SparrowTheNerd/WINTER-KiCAD/production/JLC3313-Stackup.png

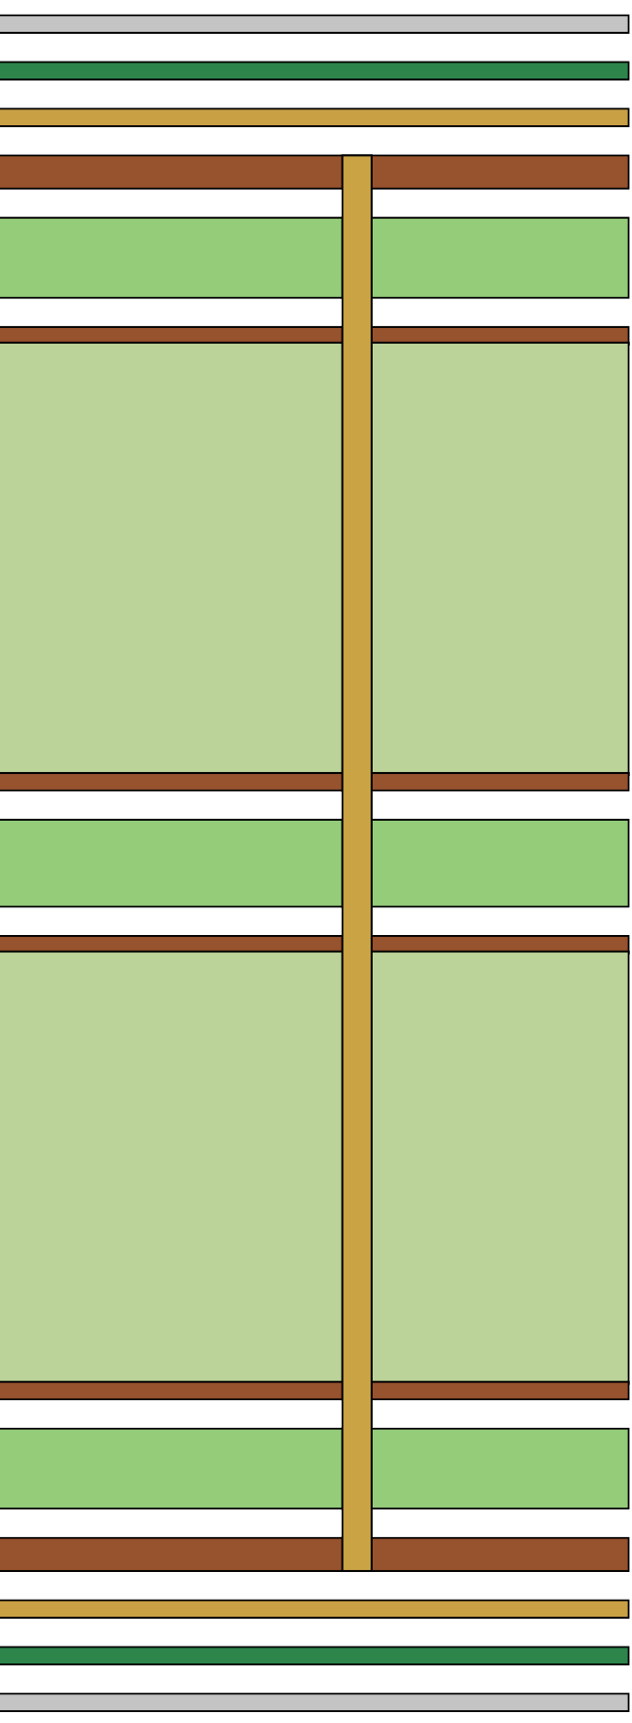
production/JLC3313-Stackup.png
