SparrowTheNerd/WINTER-KiCAD/3D models/CP-10-9_ADI.step

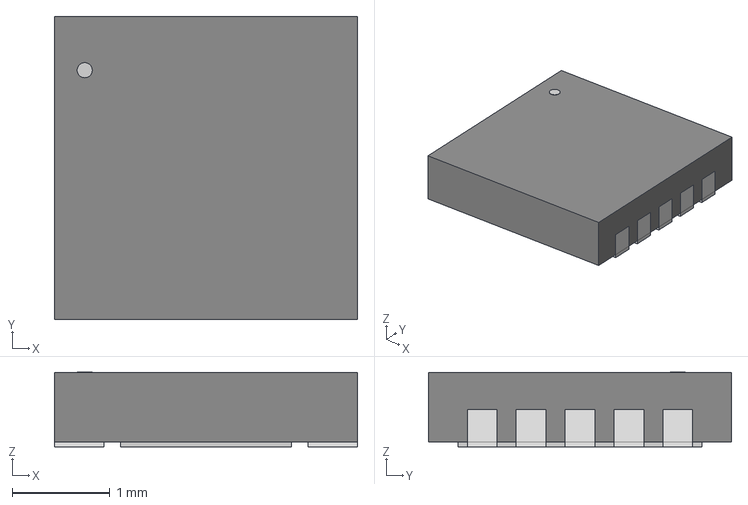
[picture p2: CAD file, 2025-11-05]
3D models/CP-10-9_ADI.step
3.10 x 3.10 x 0.765 mm
