SparrowTheNerd/WINTER-KiCAD/3D models/AP.10H.01_Web.STEP

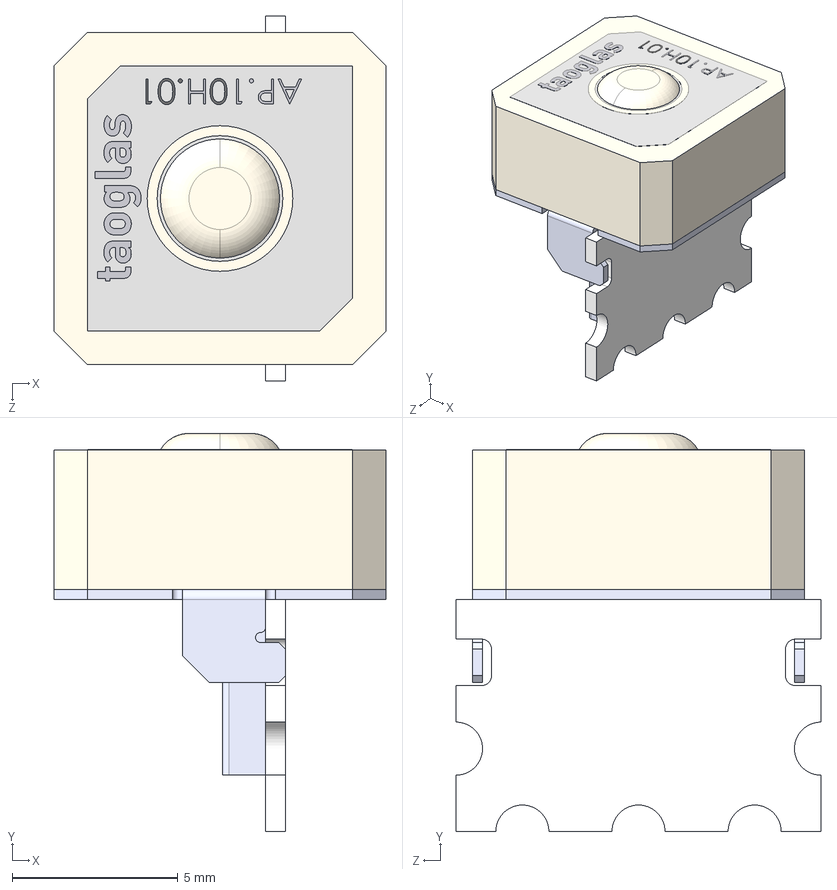
[picture p3: CAD file, 2025-11-05]
3D models/AP.10H.01_Web.STEP
10.0 x 12.0 x 11.0 mm
AP.10H_Patch
AP.10H_Patch base
AP.10H_PCB
AP.10H_Shielding case
