SparrowTheNerd/WINTER-KiCAD/3D models/TPS2121RUXR.STEP

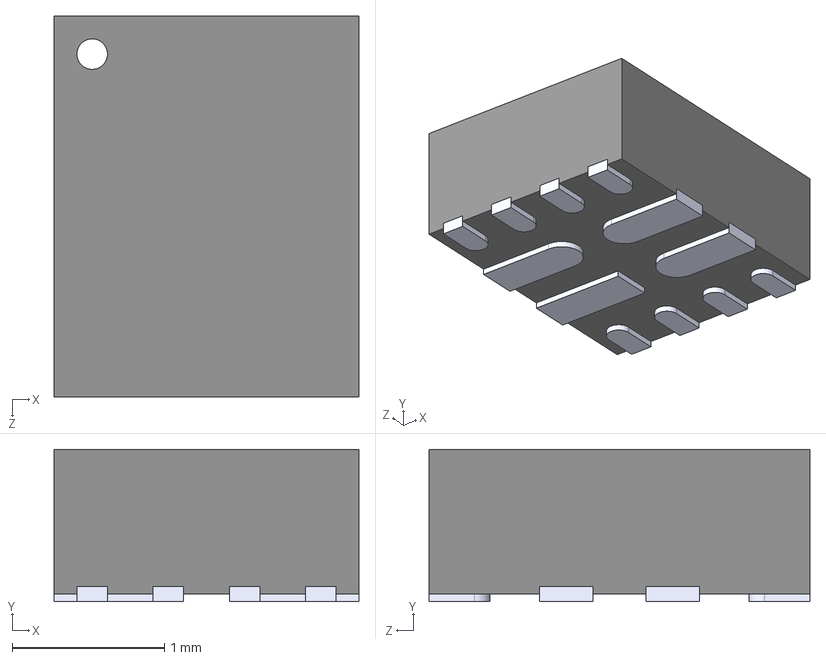
[picture p4: CAD file, 2025-11-05]
3D models/TPS2121RUXR.STEP
2.00 x 1.00 x 2.50 mm
