SparrowTheNerd/WINTER-KiCAD/3D models/2998TR.step

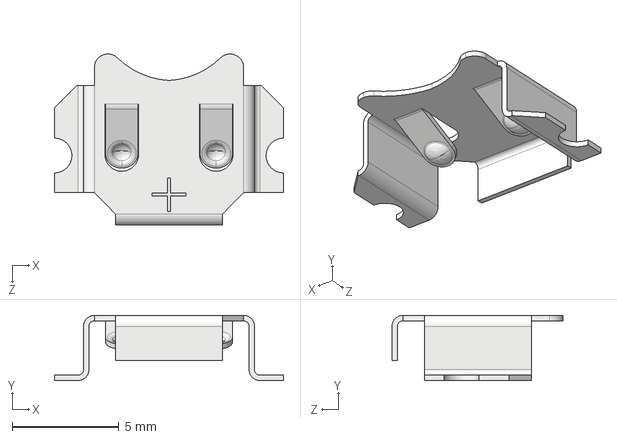
[picture p5: CAD file, 2025-09-04]
3D models/2998TR.step
10.7 x 3.05 x 8.00 mm
