SparrowTheNerd/WINTER-KiCAD/3D models/W25Q32JVSSIQ--3DModel-STEP-269445.STEP

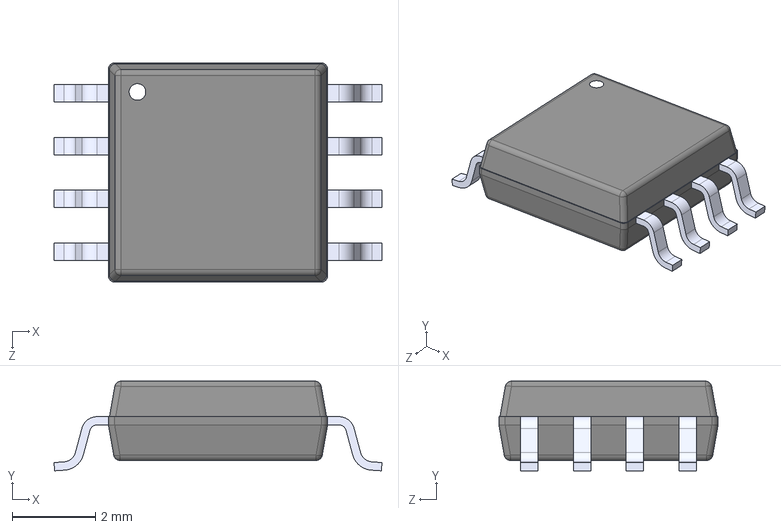
[picture p6: CAD file, 2025-06-22]
3D models/W25Q32JVSSIQ--3DModel-STEP-269445.STEP
7.90 x 2.16 x 5.28 mm
