SparrowTheNerd/WINTER-KiCAD/3D models/GGBLA.01.A.step

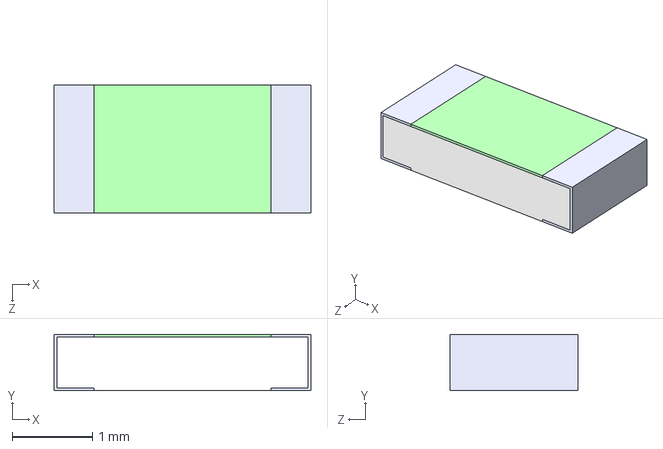
[picture p7: CAD file, 2025-06-22]
3D models/GGBLA.01.A.step
3.20 x 0.7 x 1.60 mm
