SparrowTheNerd/WINTER-KiCAD/3D models/MEM2067-02-180-00-A--3DModel-STEP-56544.STEP

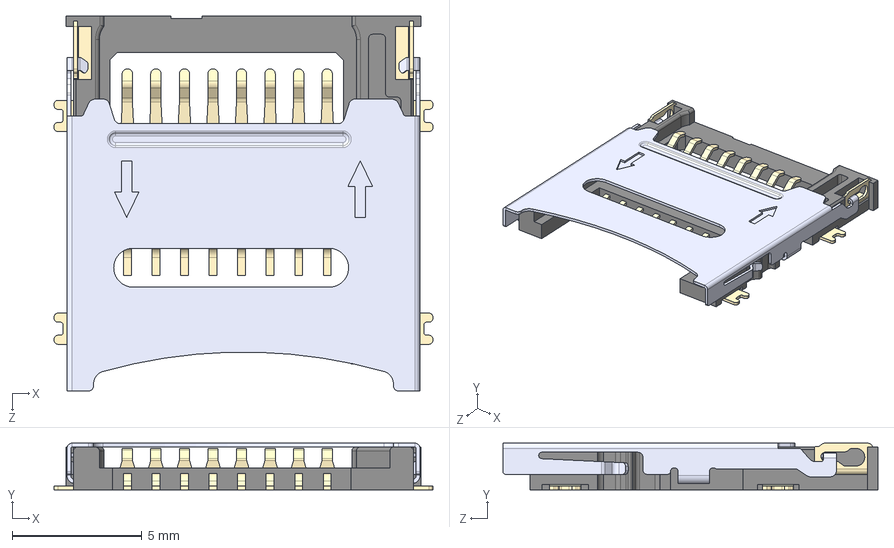
[picture p8: CAD file, 2025-06-22]
3D models/MEM2067-02-180-00-A--3DModel-STEP-56544.STEP
14.6 x 1.80 x 14.5 mm
