SparrowTheNerd/WINTER-KiCAD/3D models/u.Fl Antenna Connector - 523-A-1JB.STEP

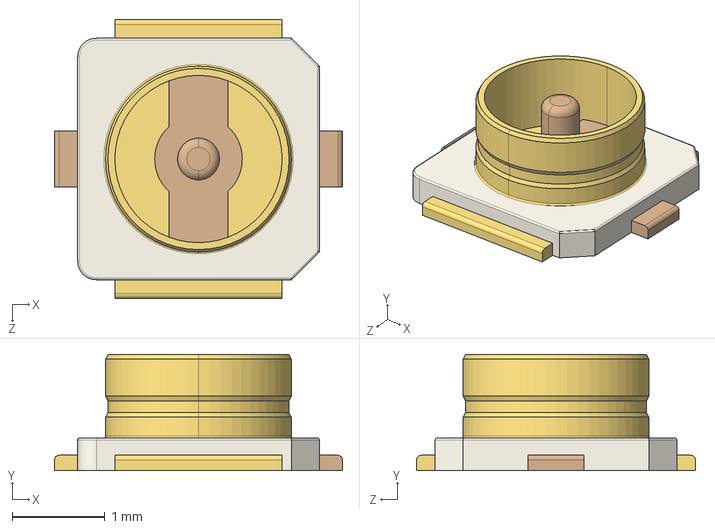
[picture p9: CAD file, 2025-06-22]
3D models/u.Fl Antenna Connector - 523-A-1JB.STEP
3.10 x 1.25 x 3.00 mm
