SparrowTheNerd/WINTER-KiCAD/3D models/MAX-M10S-00B.STEP

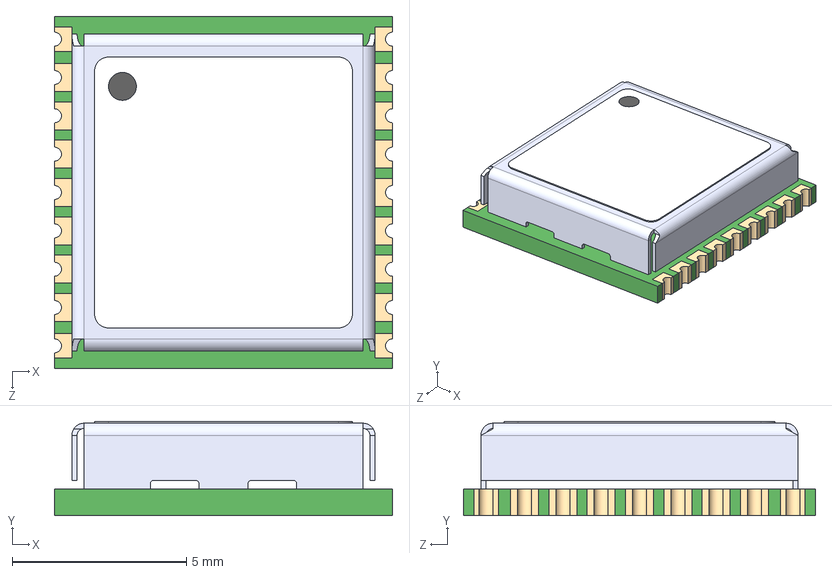
[picture p10: CAD file, 2025-06-22]
3D models/MAX-M10S-00B.STEP
9.70 x 2.70 x 10.1 mm
