SparrowTheNerd/WINTER-KiCAD/3D models/MMC5983MA_MEM.step

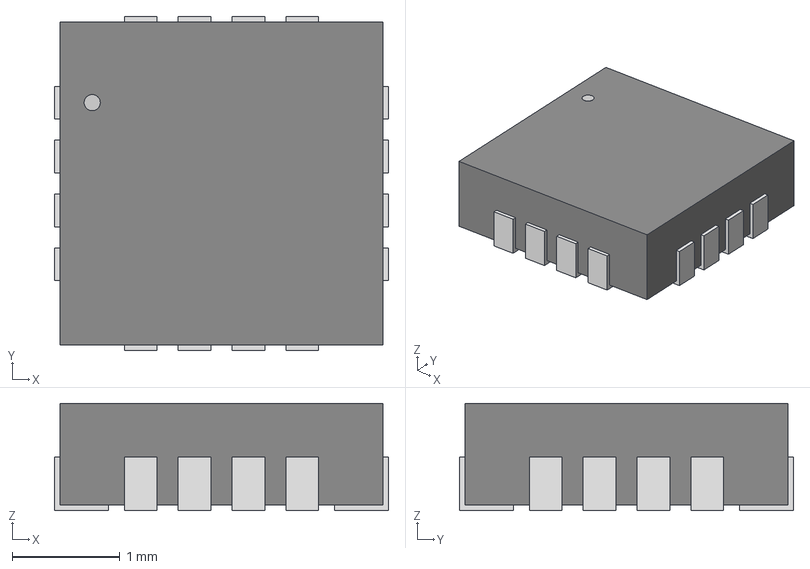
[picture p11: CAD file, 2025-06-22]
3D models/MMC5983MA_MEM.step
3.10 x 3.10 x 0.993 mm
