SparrowTheNerd/WINTER-KiCAD/3D models/AST0760_MAL.step

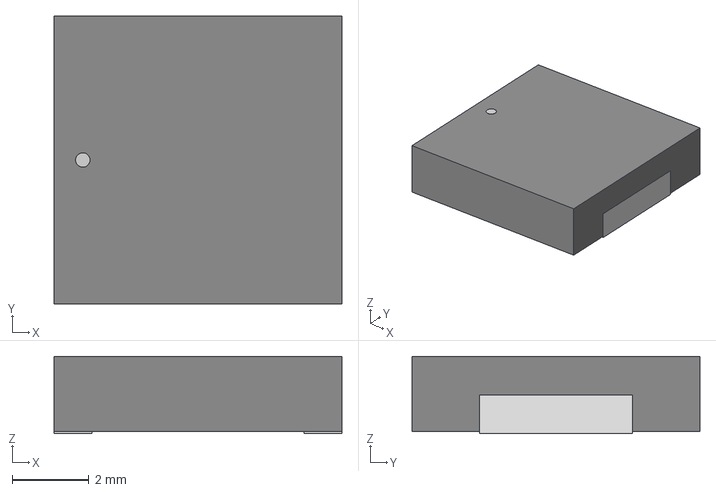
[picture p12: CAD file, 2025-06-22]
3D models/AST0760_MAL.step
7.49 x 7.49 x 2.01 mm
