SparrowTheNerd/WINTER-KiCAD/3D models/KF128-2.54-8P.step

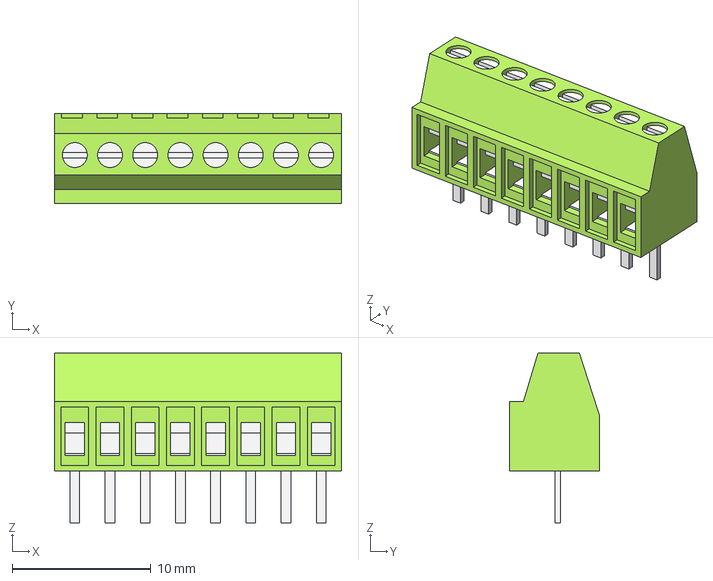
[picture p13: CAD file, 2025-06-22]
3D models/KF128-2.54-8P.step
20.7 x 6.50 x 12.3 mm
Housing
PlasticBody
