SparrowTheNerd/WINTER-KiCAD/3D models/LSM6DSO32TR.step

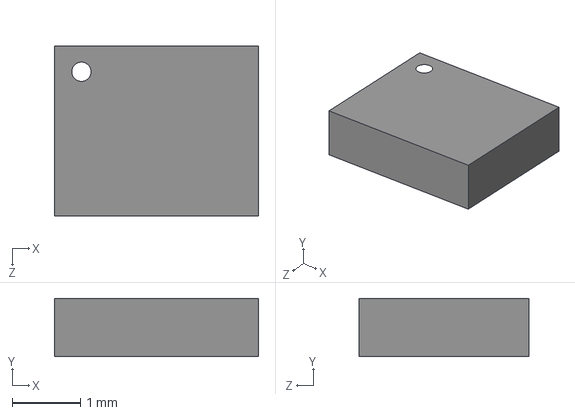
[picture p14: CAD file, 2025-06-22]
3D models/LSM6DSO32TR.step
3.00 x 0.86 x 2.50 mm
