SparrowTheNerd/WINTER-KiCAD/3D models/CP-8-11_ADI.step

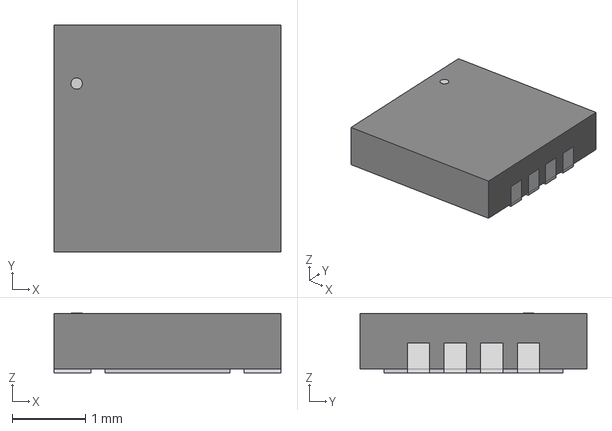
[picture p15: CAD file, 2025-06-22]
3D models/CP-8-11_ADI.step
3.10 x 3.10 x 0.815 mm
