SparrowTheNerd/WINTER-KiCAD/3D models/LM2940LD.step

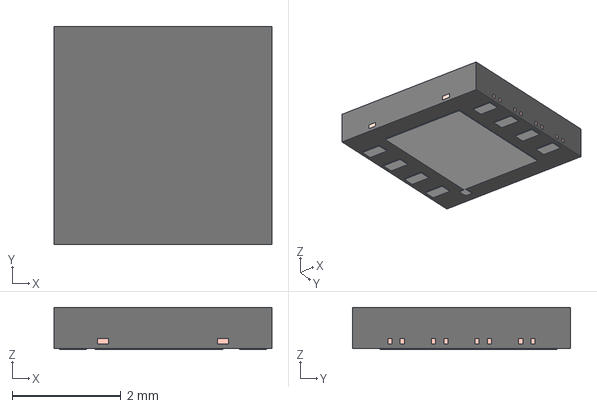
[picture p16: CAD file, 2025-06-22]
3D models/LM2940LD.step
4.00 x 4.00 x 0.775 mm
BODY-SON
FRAME-NGN0008A
