SparrowTheNerd/WINTER-KiCAD/3D models/AdafruitGPS v2.step

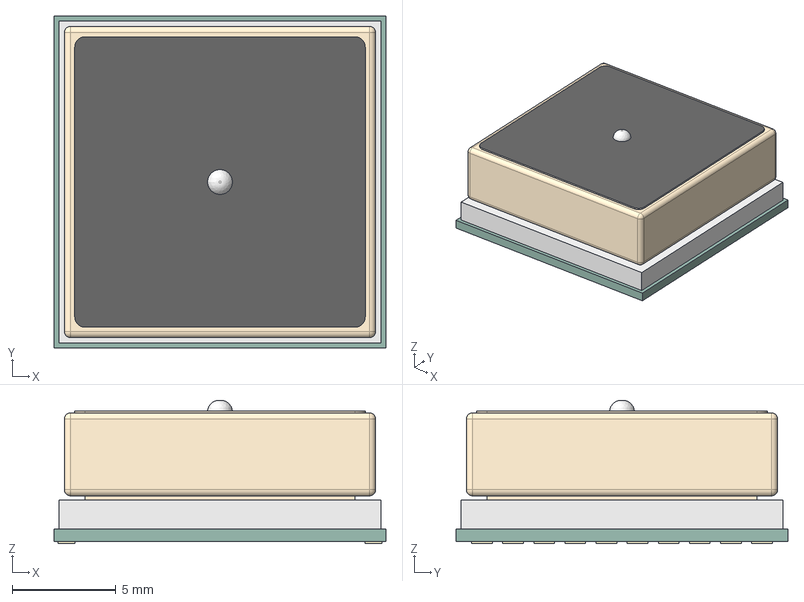
[picture p17: CAD file, 2025-06-22]
3D models/AdafruitGPS v2.step
16.0 x 16.0 x 6.90 mm
Antenna
Shield
PCB
Pads
