SparrowTheNerd/WINTER-KiCAD/3D models/TAOGLAS-SGGP.12.4.A.02 Antenna.STEP

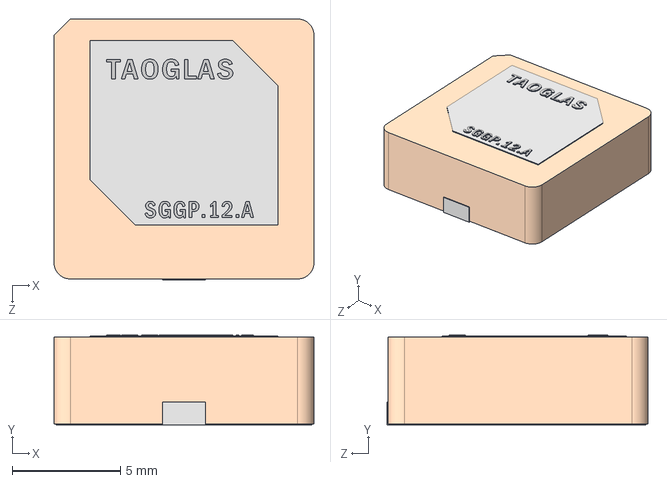
[picture p18: CAD file, 2025-06-22]
3D models/TAOGLAS-SGGP.12.4.A.02 Antenna.STEP
12.0 x 4.15 x 12.1 mm
