SparrowTheNerd/WINTER-KiCAD/3D models/RFM95CW--3DModel-STEP-269445.STEP

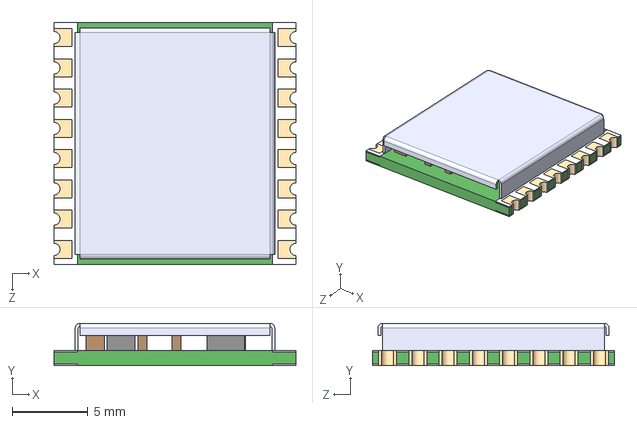
[picture p19: CAD file, 2025-06-22]
3D models/RFM95CW--3DModel-STEP-269445.STEP
16.0 x 2.80 x 16.0 mm
