SparrowTheNerd/WINTER-KiCAD/3D models/SI7232DN-T1-GE3.step

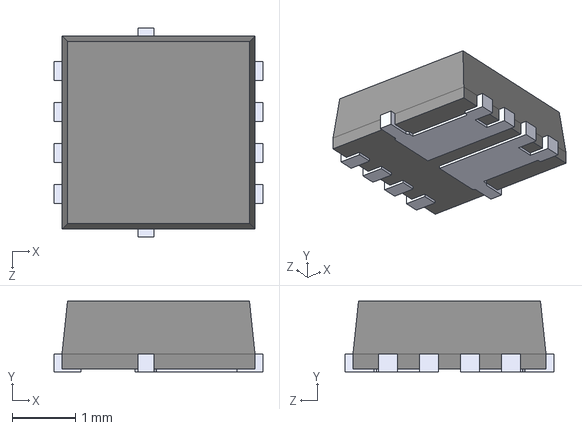
[picture p20: CAD file, 2025-06-22]
3D models/SI7232DN-T1-GE3.step
3.30 x 1.12 x 3.30 mm
