SparrowTheNerd/WINTER-KiCAD/3D models/ICM-42688-P.step

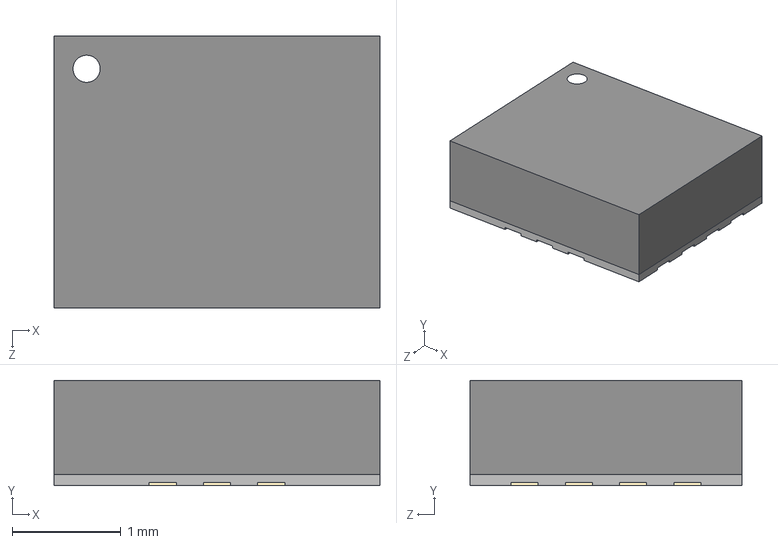
[picture p21: CAD file, 2025-06-22]
3D models/ICM-42688-P.step
3.00 x 0.97 x 2.50 mm
