SparrowTheNerd/WINTER-KiCAD/3D models/DRV8210DRLR.step

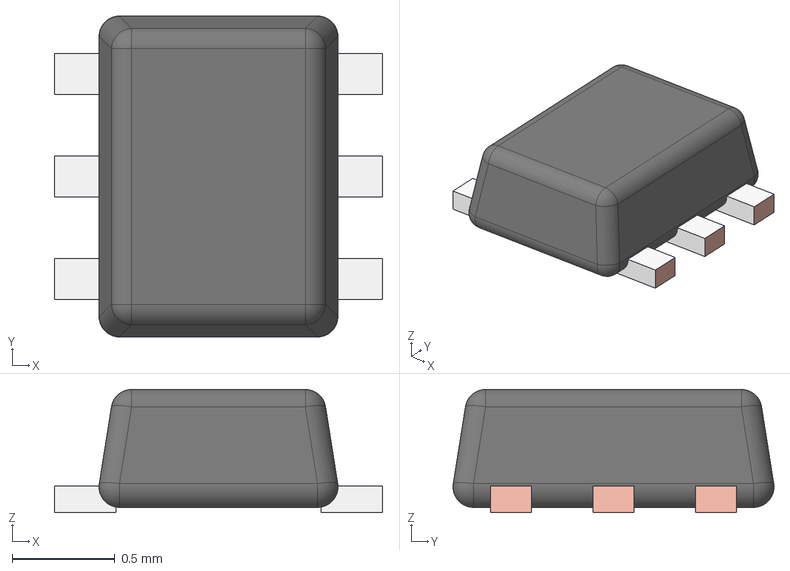
[picture p22: CAD file, 2025-06-22]
3D models/DRV8210DRLR.step
1.60 x 1.57 x 0.6 mm
FRAME-DRL0006A
BODY-SOT
PIN1-ID
