SparrowTheNerd/WINTER-KiCAD/3D models/ECS-2520MV-250-CN-TR.STEP

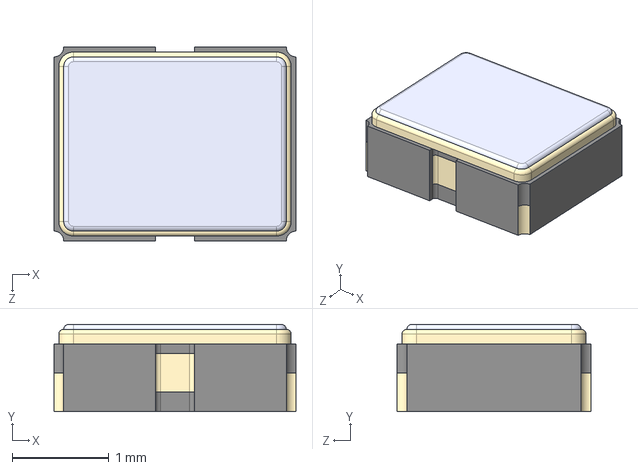
[picture p23: CAD file, 2025-06-22]
3D models/ECS-2520MV-250-CN-TR.STEP
2.50 x 0.9 x 2.00 mm
