SparrowTheNerd/WINTER-KiCAD/3D models/USB3076-30-A--3DModel-STEP-56544.STEP

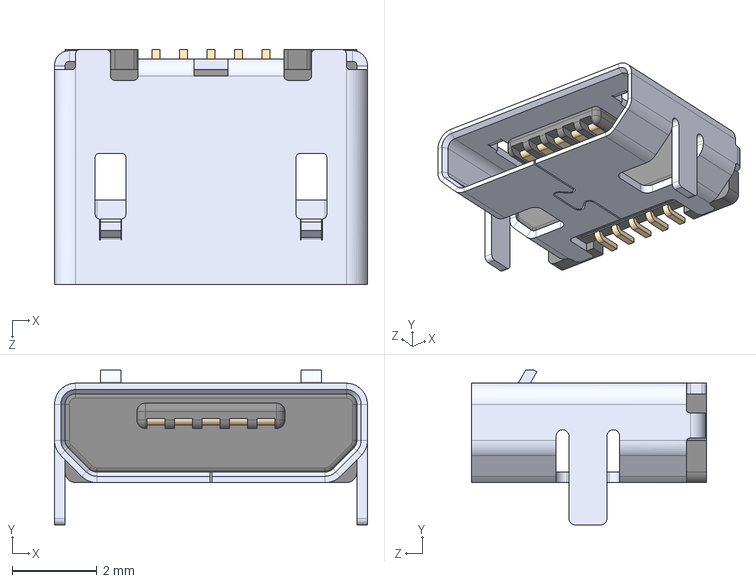
[picture p24: CAD file, 2025-06-22]
3D models/USB3076-30-A--3DModel-STEP-56544.STEP
7.40 x 3.66 x 5.55 mm
