SparrowTheNerd/WINTER-KiCAD/3D models/SOT1215.STEP

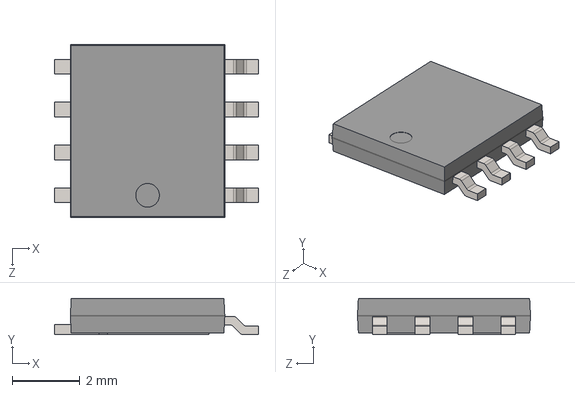
[picture p25: CAD file, 2025-06-22]
3D models/SOT1215.STEP
6.04 x 1.07 x 5.12 mm
