SparrowTheNerd/WINTER-KiCAD/3D models/SMT-0840-T--3DModel-STEP-461651.STEP

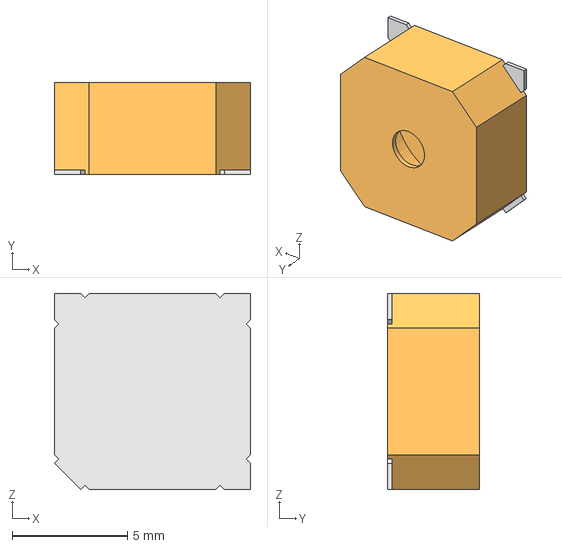
[picture p26: CAD file, 2025-06-22]
3D models/SMT-0840-T--3DModel-STEP-461651.STEP
8.50 x 4.00 x 8.50 mm
