SparrowTheNerd/WINTER-KiCAD/3D models/c-282834-8-c-3d.stp

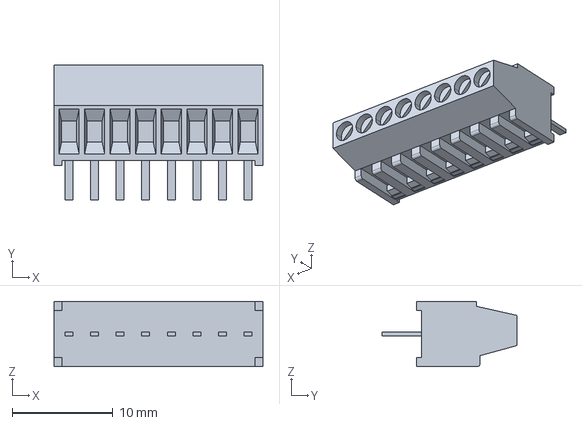
[picture p27: CAD file, 2025-06-22]
3D models/c-282834-8-c-3d.stp
20.8 x 13.4 x 6.50 mm
