SparrowTheNerd/WINTER-KiCAD/3D models/CON-SMA-EDGE-S--3DModel-STEP-269445.STEP

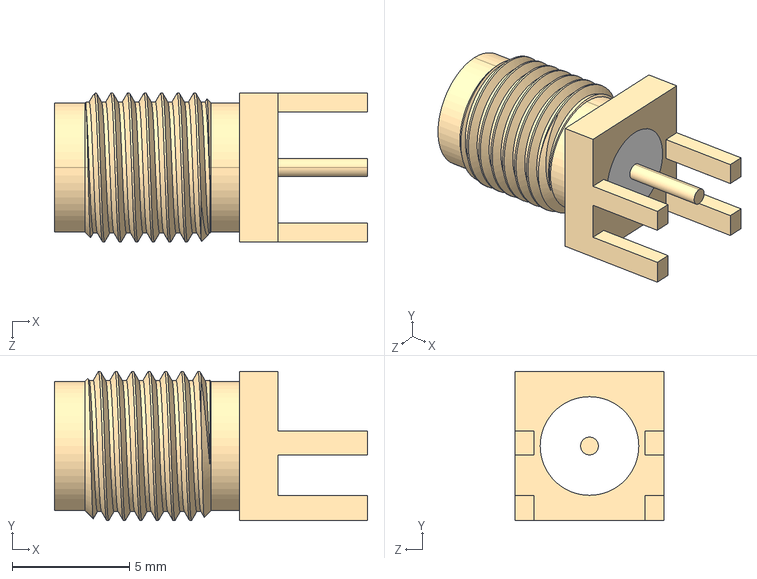
[picture p28: CAD file, 2025-06-22]
3D models/CON-SMA-EDGE-S--3DModel-STEP-269445.STEP
13.3 x 6.35 x 6.35 mm
