SparrowTheNerd/WINTER-KiCAD/3D models/CC1190RGVT.step

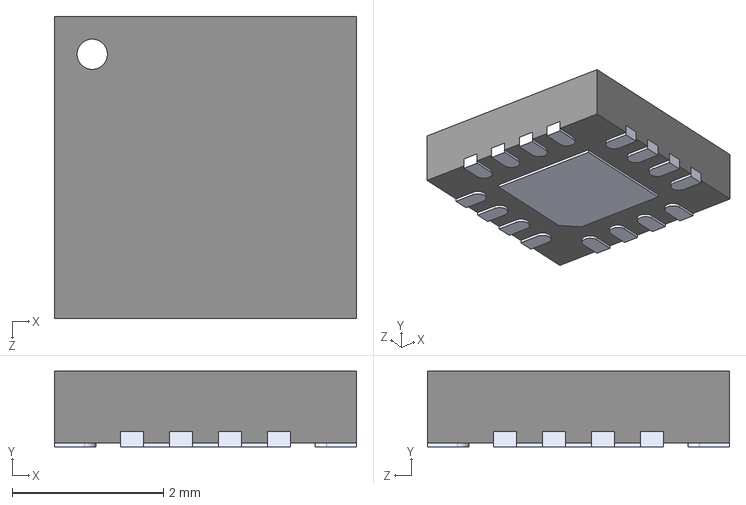
[picture p29: CAD file, 2025-06-22]
3D models/CC1190RGVT.step
4.00 x 1.00 x 4.00 mm
