SparrowTheNerd/WINTER-KiCAD/3D models/PTS810 SJK 250 SMTR LFS--3DModel-STEP-1.STEP

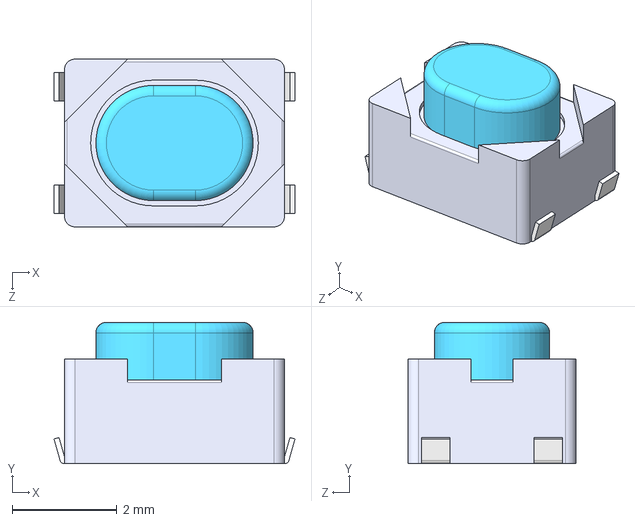
[picture p30: CAD file, 2025-06-22]
3D models/PTS810 SJK 250 SMTR LFS--3DModel-STEP-1.STEP
4.60 x 2.70 x 3.20 mm
