SparrowTheNerd/WINTER-KiCAD/(list of files, cad)

Other CAD files:
3D models/0472192001.step
3D models/10118193-0001LF.step
3D models/LM62460Q3RPHRQ1.stp
3D models/SKY66105.STEP
