SparrowTheNerd/WINTER-KiCAD/production/WINTER Stackup & Dimensions.pdf

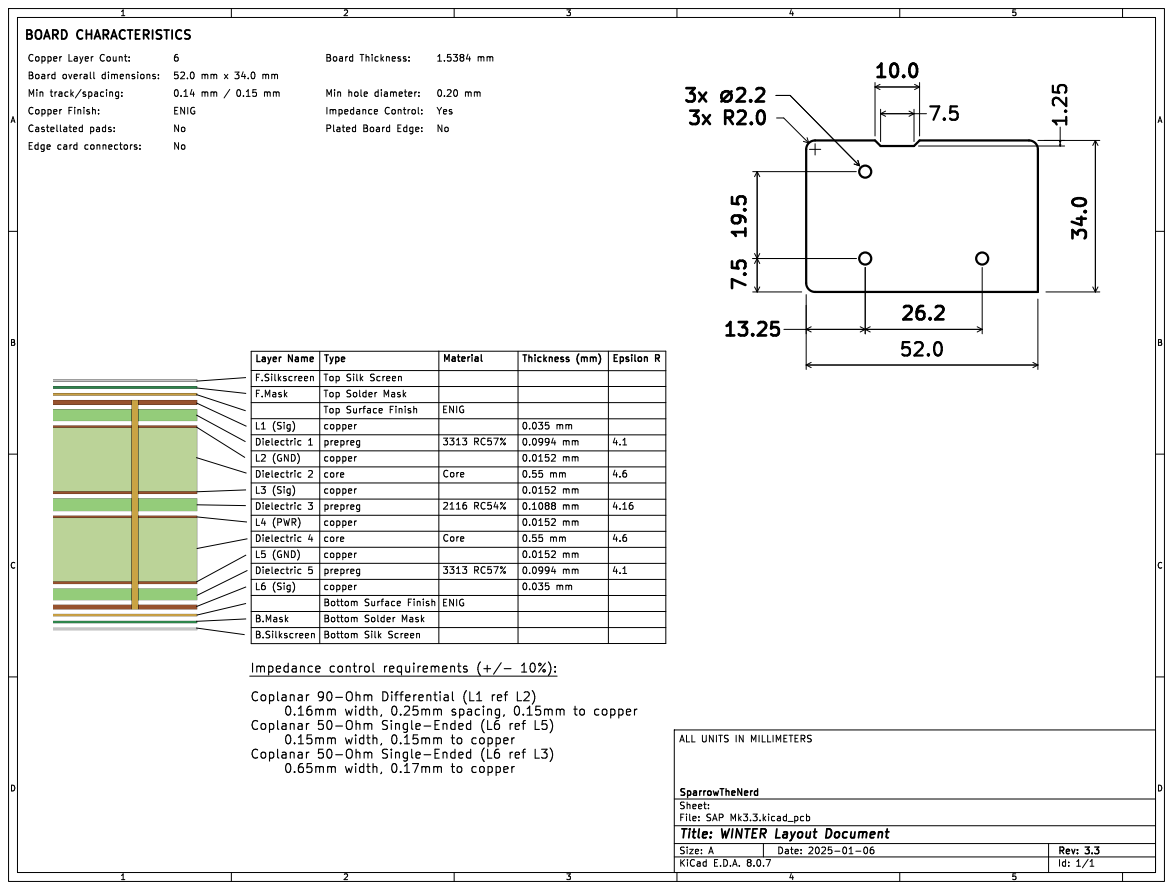
[picture p31: page 1]
