SparrowTheNerd/WINTER-KiCAD/(list of files, drawings)

Other design files:
Datasheets etc/SX1262/SX1262-IPD-Design/SX126xIPD_868-915MHz_Altium_PCB_Package/SX126xMB2xAS_e588v01a.PcbDoc
Datasheets etc/SX1262/SX1262-IPD-Design/SX126xIPD_868-915MHz_Altium_PCB_Package/SX126xMB2xAS_e588v01a.PcbLib
Datasheets etc/SX1262/SX1262-IPD-Design/SX126xIPD_868-915MHz_Altium_PCB_Package/SX126xMB2xAS_e588v01a.PrjPCB
Datasheets etc/SX1262/SX1262-IPD-Design/SX126xIPD_868-915MHz_Altium_PCB_Package/SX126xMB2xAS_e588v01a.SchDoc
Datasheets etc/SX1262/SX1262-IPD-Design/SX126xIPD_868-915MHz_Altium_PCB_Package/SX126xMB2xAS_e588v01a.SchLib
