SparrowTheNerd/WINTER-KiCAD/WINTER.kicad_pcb

## KiCad design WINTER.kicad_pcb (2025-11-26)

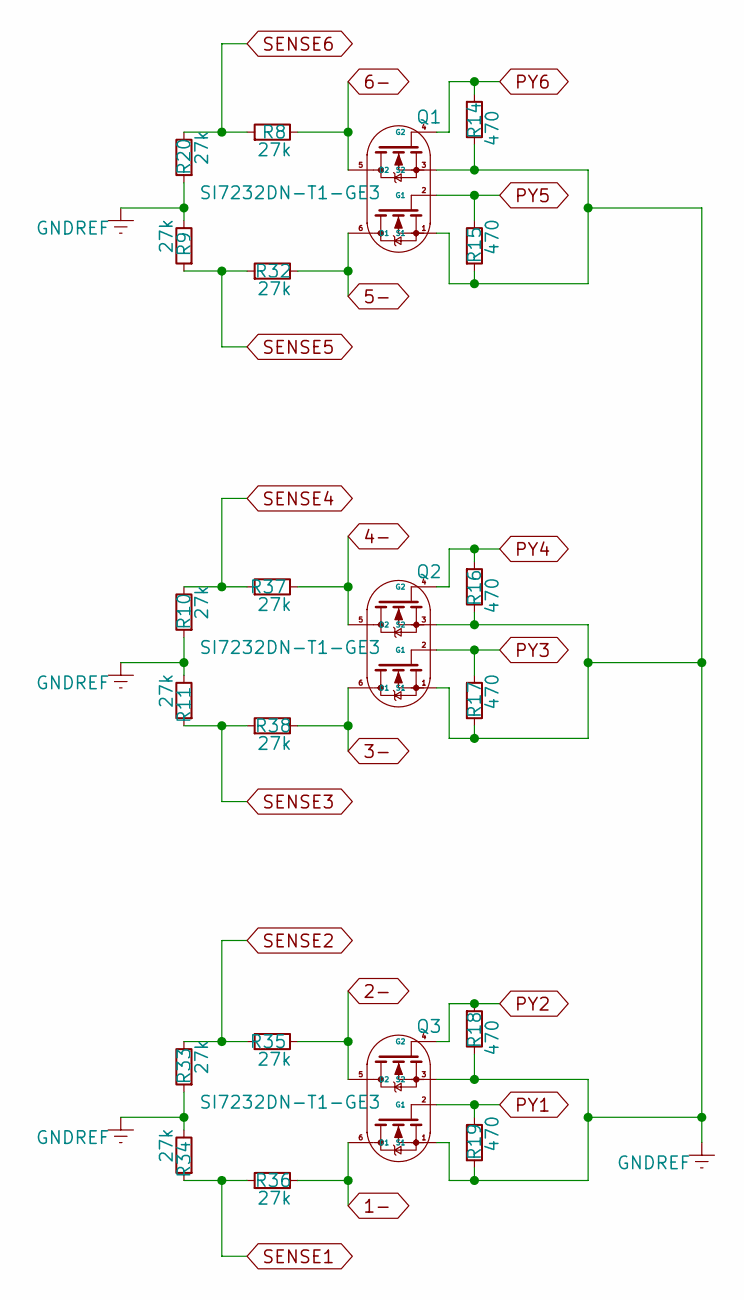
[picture p32: schematic pyro.kicad_sch, WINTER Pyro Channels]

Parts:
Q1, Q2, Q3: SI7232DN-T1-GE3; TRANS_SI7232DN-T1-GE3; LCSC C144854
R8, R32, R35, R36, R37, R38: 27k; R_0603_1608Metric; LCSC C22967
R9, R10, R11, R20, R33, R34: 27k; R_0603_1608Metric; LCSC C25803
R14, R15, R16, R17, R18, R19: 470; R_0603_1608Metric; LCSC C23179

Connections:
1-: Q3.6 (D1), R36.2; also elsewhere on the board
2-: Q3.5 (D2), R35.2; also elsewhere on the board
3-: Q2.6 (D1), R38.2; also elsewhere on the board
4-: Q2.5 (D2), R37.2; also elsewhere on the board
5-: Q1.6 (D1), R32.2; also elsewhere on the board
6-: Q1.5 (D2), R8.2; also elsewhere on the board
GNDREF: Q1.1 (S1), Q1.3 (S2), Q2.1 (S1), Q2.3 (S2), Q3.1 (S1), Q3.3 (S2), R9.2, R10.1, R11.2, R14.2, R15.1, R16.2, R17.1, R18.2, R19.1, R20.1, R33.1, R34.2; also elsewhere on the board
PY1: Q3.2 (G1), R19.2; also elsewhere on the board
PY2: Q3.4 (G2), R18.1; also elsewhere on the board
PY3: Q2.2 (G1), R17.2; also elsewhere on the board
PY4: Q2.4 (G2), R16.1; also elsewhere on the board
PY5: Q1.2 (G1), R15.2; also elsewhere on the board
PY6: Q1.4 (G2), R14.1; also elsewhere on the board
SENSE1: R34.1, R36.1; also elsewhere on the board
SENSE2: R33.2, R35.1; also elsewhere on the board
SENSE3: R11.1, R38.1; also elsewhere on the board
SENSE4: R10.2, R37.1; also elsewhere on the board
SENSE5: R9.1, R32.1; also elsewhere on the board
SENSE6: R8.1, R20.2; also elsewhere on the board

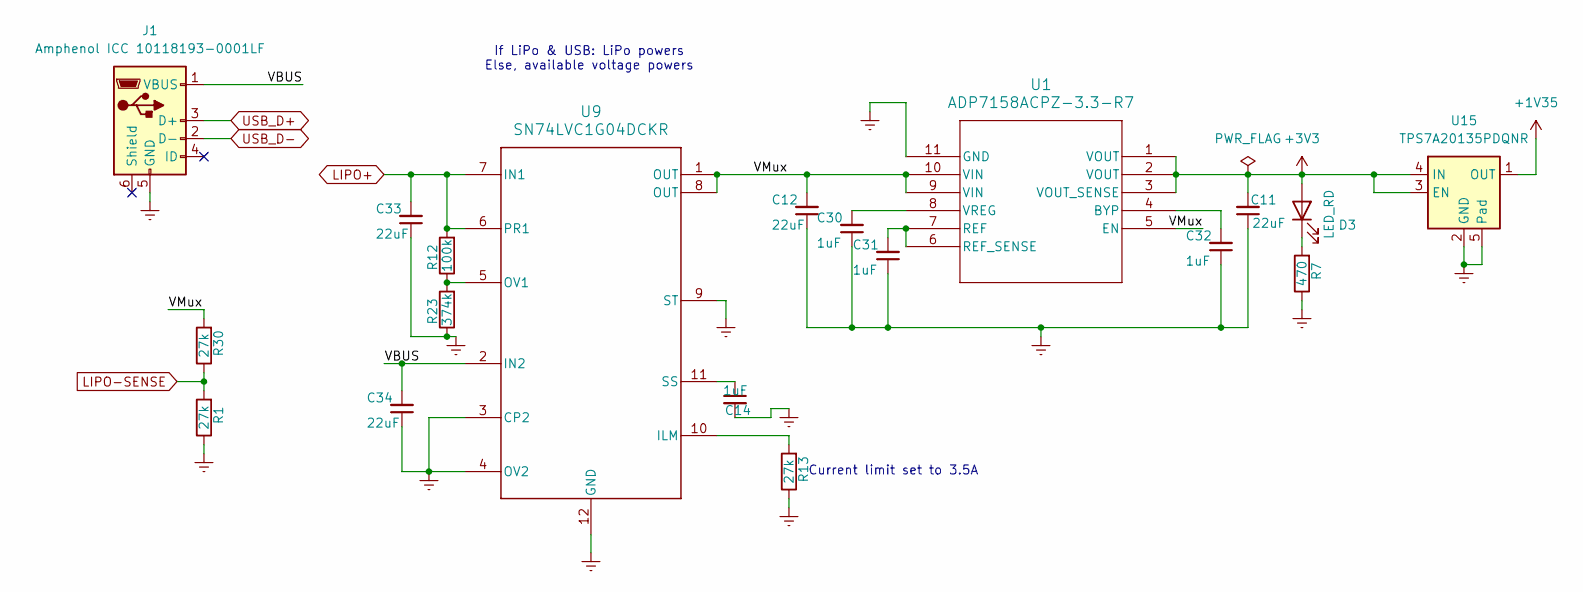
[picture p33: schematic Power.kicad_sch, WINTER Power Systems]

Parts:
C11, C12, C33, C34: 22uF; C_0603_1608Metric; LCSC C96446
C14: 1uF; C_0603_1608Metric; LCSC C1525
C30, C31, C32: 1uF; C_0603_1608Metric; LCSC C96446
D3: LED_RD; LED_0603_1608Metric; LCSC C2286
J1: Amphenol ICC 10118193-0001LF; USB_Micro-B_Amphenol_10118193-0001LF_Horizontal; LCSC C132562
R1, R13, R30: 27k; R_0603_1608Metric; LCSC C22967
R7: 470; R_0603_1608Metric; LCSC C23179
R12: 100k; R_0603_1608Metric; LCSC C23162
R23: 374k; R_0603_1608Metric
U1: ADP7158ACPZ-3.3-R7; CP-10-9_ADI
U9: SN74LVC1G04DCKR; RUX0012A
U15: TPS7A20135PDQNR; Texas_X2SON-4_1x1mm_P0.65mm

Connections:
+1V35: U15.1 (OUT); also elsewhere on the board
+3V3: C11.2, D3.2 (A), U1.1 (VOUT), U1.2 (VOUT), U1.3 (VOUT_SENSE), U15.3 (EN), U15.4 (IN); also elsewhere on the board
/Power/VBUS: C34.2, J1.1 (VBUS), U9.2 (IN2)
/Power/VMux: C12.2, R30.2, U1.5 (EN), U1.9 (VIN), U1.10 (VIN), U9.1 (OUT), U9.8 (OUT)
GNDREF: C11.1, C12.1, C14.2, C30.1, C31.1, C32.1, C33.1, C34.1, J1.5 (GND), R1.1, R7.1, R13.1, R23.1, U1.11 (GND), U9.3 (CP2), U9.4 (OV2), U9.9 (ST), U9.12 (GND), U15.2 (GND), U15.5 (Pad); also elsewhere on the board
LIPO+: C33.2, R12.2, U9.6 (PR1), U9.7 (IN1); also elsewhere on the board
LIPO-SENSE: R1.2, R30.1; also elsewhere on the board
unnamed: D3.1 (K), R7.2
unnamed: C32.2, U1.4 (BYP)
unnamed: C31.2, U1.6 (REF_SENSE), U1.7 (REF)
unnamed: C30.2, U1.8 (VREG)
unnamed: R13.2, U9.10 (ILM)
unnamed: R12.1, R23.2, U9.5 (OV1)
unnamed: C14.1, U9.11 (SS)
USB_D+: J1.3 (D+); also elsewhere on the board
USB_D-: J1.2 (D-); also elsewhere on the board

Notes on the sheet:
If LiPo & USB: LiPo powers Else, available voltage powers
Current limit set to 3.5A

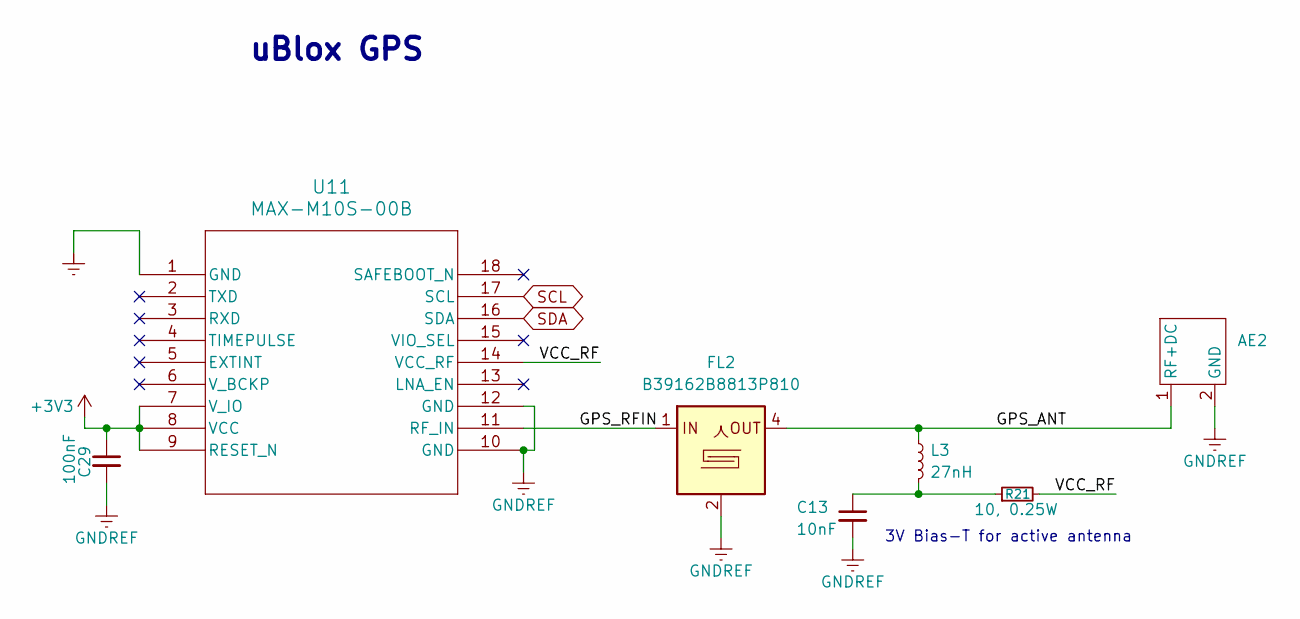
[picture p34: schematic GPS.kicad_sch, WINTER GPS]

Parts:
AE2: AP.10H.01
C13: 10nF; C_0603_1608Metric
C29: 100nF; C_0603_1608Metric; LCSC C1590
FL2: B39162B8813P810; Filter_1109-5_1.1x0.9mm
L3: 27nH; L_0402_1005Metric
R21: 10, 0.25W; R_0603_1608Metric
U11: MAX-M10S-00B; LCSC C4153167

Connections:
+3V3: C29.1, U11.7 (V_IO), U11.8 (VCC), U11.9 (RESET_N); also elsewhere on the board
/GPS/GPS_ANT: AE2.1 (RF+DC), FL2.4, L3.1
/GPS/GPS_RFIN: FL2.1, U11.11 (RF_IN)
/GPS/VCC_RF: R21.2, U11.14 (VCC_RF)
GNDREF: AE2.2 (GND), AE2.3 (GND), AE2.4 (GND), AE2.5 (GND), C13.2, C29.2, FL2.2, FL2.3, FL2.5, U11.1 (GND), U11.10 (GND), U11.12 (GND); also elsewhere on the board
unnamed: C13.1, L3.2, R21.1
SCL: U11.17 (SCL); also elsewhere on the board
SDA: U11.16 (SDA); also elsewhere on the board

Notes on the sheet:
uBlox GPS
3V Bias-T for active antenna

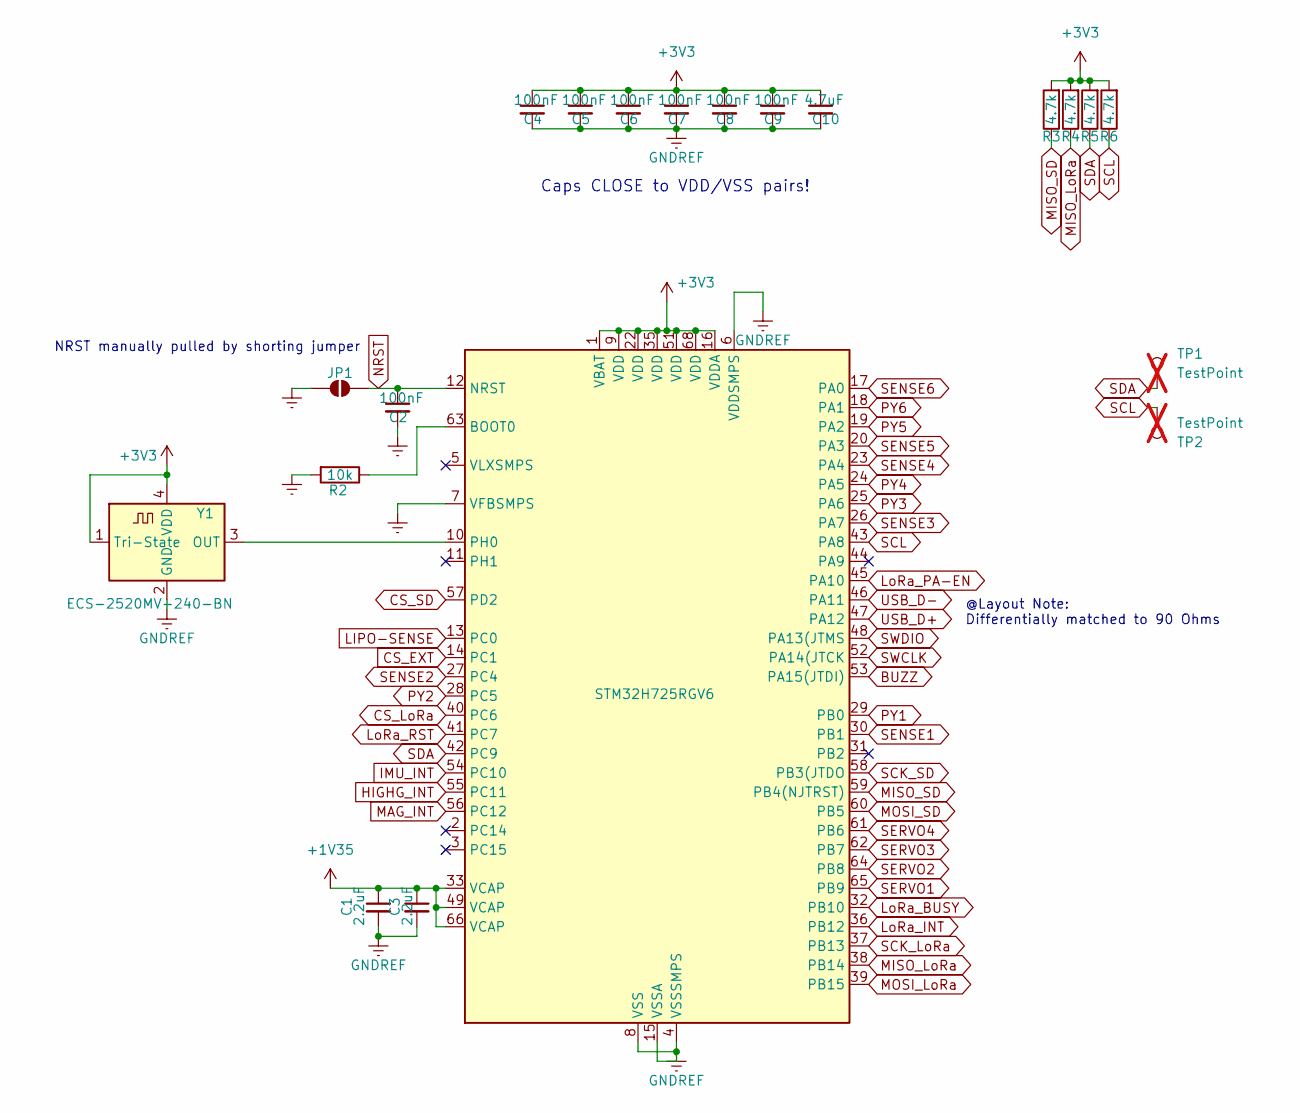
[picture p35: schematic microcontroller.kicad_sch, WINTER Microcontroller Layout]

Parts:
C1, C3: 2.2uF; C_0603_1608Metric; LCSC C23630
C2: 100nF; C_0603_1608Metric; LCSC C1590
C4, C5, C6, C7, C8, C9: 100nF; C_0603_1608Metric; LCSC C1525
C10: 4.7uF; C_0603_1608Metric; LCSC C23733
JP1: SolderJumper_2_Open; SolderJumper-2_P1.3mm_Open_RoundedPad1.0x1.5mm
R2: 10k; R_0603_1608Metric; LCSC C25804
R3, R4, R5, R6: 4.7k; R_0603_1608Metric; LCSC C23162
TP1, TP2: TestPoint; TestPoint_Pad_D1.0mm; LCSC DNP; not fitted
U6: STM32H725RGV6; QFN-68-1EP_8x8mm_P0.4mm_EP5.2x5.2mm; LCSC C5271079
Y1: ECS-2520MV-240-BN; Oscillator_SMD_ECS_2520MV-xxx-xx-4Pin_2.5x2.0mm; LCSC C437141

Connections:
+1V35: C1.1, C3.1, U6.33 (VCAP), U6.49 (VCAP), U6.66 (VCAP); also elsewhere on the board
+3V3: C4.1, C5.1, C6.1, C7.1, C8.1, C9.1, C10.1, R3.2, R4.2, R5.2, R6.2, U6.1 (VBAT), U6.9 (VDD), U6.16 (VDDA), U6.22 (VDD), U6.35 (VDD), U6.51 (VDD), U6.68 (VDD), Y1.1 (Tri-State), Y1.4 (VDD); also elsewhere on the board
BUZZ: U6.53 (PA15(JTDI)); also elsewhere on the board
CS_EXT: U6.14 (PC1); also elsewhere on the board
CS_LoRa: U6.40 (PC6); also elsewhere on the board
CS_SD: U6.57 (PD2); also elsewhere on the board
GNDREF: C1.2, C2.2, C3.2, C4.2, C5.2, C6.2, C7.2, C8.2, C9.2, C10.2, JP1.1 (A), R2.2, U6.4 (VSSSMPS), U6.6 (VDDSMPS), U6.7 (VFBSMPS), U6.8 (VSS), U6.15 (VSSA), U6.21 (VSS), U6.34 (VSS), U6.50 (VSS), U6.67 (VSS), U6.69 (VSS), Y1.2 (GND); also elsewhere on the board
HIGHG_INT: U6.55 (PC11); also elsewhere on the board
IMU_INT: U6.54 (PC10); also elsewhere on the board
LIPO-SENSE: U6.13 (PC0); also elsewhere on the board
LoRa_BUSY: U6.32 (PB10); also elsewhere on the board
LoRa_INT: U6.36 (PB12); also elsewhere on the board
LoRa_PA-EN: U6.45 (PA10); also elsewhere on the board
LoRa_RST: U6.41 (PC7); also elsewhere on the board
MAG_INT: U6.56 (PC12); also elsewhere on the board
MISO_LoRa: R4.1, U6.38 (PB14); also elsewhere on the board
MISO_SD: R3.1, U6.59 (PB4(NJTRST)); also elsewhere on the board
MOSI_LoRa: U6.39 (PB15); also elsewhere on the board
MOSI_SD: U6.60 (PB5); also elsewhere on the board
NRST: C2.1, JP1.2 (B), U6.12 (NRST); also elsewhere on the board
unnamed: R2.1, U6.63 (BOOT0)
unnamed: U6.10 (PH0), Y1.3 (OUT)
PY1: U6.29 (PB0); also elsewhere on the board
PY2: U6.28 (PC5); also elsewhere on the board
PY3: U6.25 (PA6); also elsewhere on the board
PY4: U6.24 (PA5); also elsewhere on the board
PY5: U6.19 (PA2); also elsewhere on the board
PY6: U6.18 (PA1); also elsewhere on the board
SCK_LoRa: U6.37 (PB13); also elsewhere on the board
SCK_SD: U6.58 (PB3(JTDO); also elsewhere on the board
SCL: R6.1, TP2.1, U6.43 (PA8); also elsewhere on the board
SDA: R5.1, TP1.1, U6.42 (PC9); also elsewhere on the board
SENSE1: U6.30 (PB1); also elsewhere on the board
SENSE2: U6.27 (PC4); also elsewhere on the board
SENSE3: U6.26 (PA7); also elsewhere on the board
SENSE4: U6.23 (PA4); also elsewhere on the board
SENSE5: U6.20 (PA3); also elsewhere on the board
SENSE6: U6.17 (PA0); also elsewhere on the board
SERVO1: U6.65 (PB9); also elsewhere on the board
SERVO2: U6.64 (PB8); also elsewhere on the board
SERVO3: U6.62 (PB7); also elsewhere on the board
SERVO4: U6.61 (PB6); also elsewhere on the board
SWCLK: U6.52 (PA14(JTCK); also elsewhere on the board
SWDIO: U6.48 (PA13(JTMS); also elsewhere on the board
USB_D+: U6.47 (PA12); also elsewhere on the board
USB_D-: U6.46 (PA11); also elsewhere on the board

Notes on the sheet:
Caps CLOSE to VDD/VSS pairs!
NRST manually pulled by shorting jumper
@Layout Note: Differentially matched to 90 Ohms

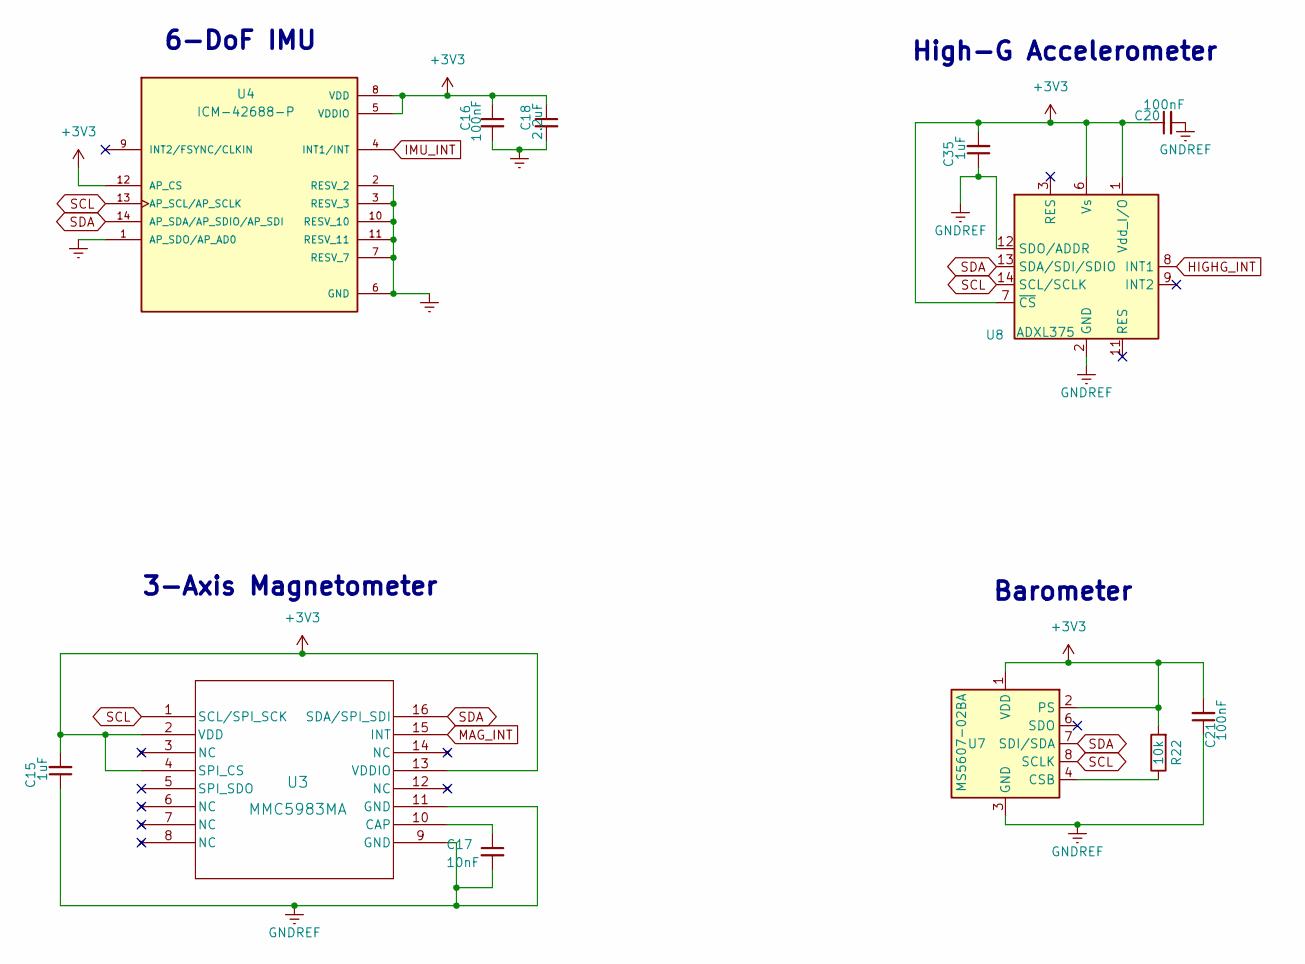
[picture p36: schematic Sensors.kicad_sch, WINTER Sensors]

Parts:
C15, C35: 1uF; C_0603_1608Metric
C16, C20, C21: 100nF; C_0603_1608Metric; LCSC C1525
C17: 10nF; C_0603_1608Metric
C18: 2.2uF; C_0603_1608Metric; LCSC C23630
R22: 10k; R_0603_1608Metric; LCSC C25804
U3: MMC5983MA; MMC5983MA_MEM; LCSC C404329
U4: ICM-42688-P; PQFN50P300X250X97-14N; PARTREV 1.2; LCSC C1850418
U7: MS5607-02BA; LGA-8_3x5mm_P1.25mm; LCSC C97627
U8: ADXL375; LGA-14_3x5mm_P0.8mm_LayoutBorder1x6y; LCSC C481898

Connections:
+3V3: C15.2, C16.1, C18.1, C20.1, C21.2, C35.2, R22.2, U3.2 (VDD), U3.4 (SPI_CS), U3.13 (VDDIO), U4.5 (VDDIO), U4.8 (VDD), U4.12 (AP_CS), U7.1 (VDD), U7.2 (PS), U8.1 (Vdd_I/O), U8.6 (Vs), U8.7 (~CS); also elsewhere on the board
GNDREF: C15.1, C16.2, C17.2, C18.2, C20.2, C21.1, C35.1, U3.9 (GND), U3.11 (GND), U4.1 (AP_SDO/AP_AD0), U4.2 (RESV_2), U4.3 (RESV_3), U4.6 (GND), U4.7 (RESV_7), U4.10 (RESV_10), U4.11 (RESV_11), U7.3 (GND), U8.2 (GND), U8.4 (GND), U8.5 (GND), U8.12 (SDO/ADDR); also elsewhere on the board
HIGHG_INT: U8.8 (INT1); also elsewhere on the board
IMU_INT: U4.4 (INT1/INT); also elsewhere on the board
MAG_INT: U3.15 (INT); also elsewhere on the board
unnamed: R22.1, U7.4 (CSB), U7.5 (CSB)
unnamed: C17.1, U3.10 (CAP)
SCL: U3.1 (SCL/SPI_SCK), U4.13 (AP_SCL/AP_SCLK), U7.8 (SCLK), U8.14 (SCL/SCLK); also elsewhere on the board
SDA: U3.16 (SDA/SPI_SDI), U4.14 (AP_SDA/AP_SDIO/AP_SDI), U7.7 (SDI/SDA), U8.13 (SDA/SDI/SDIO); also elsewhere on the board

Notes on the sheet:
3-Axis Magnetometer
Barometer
6-DoF IMU
High-G Accelerometer

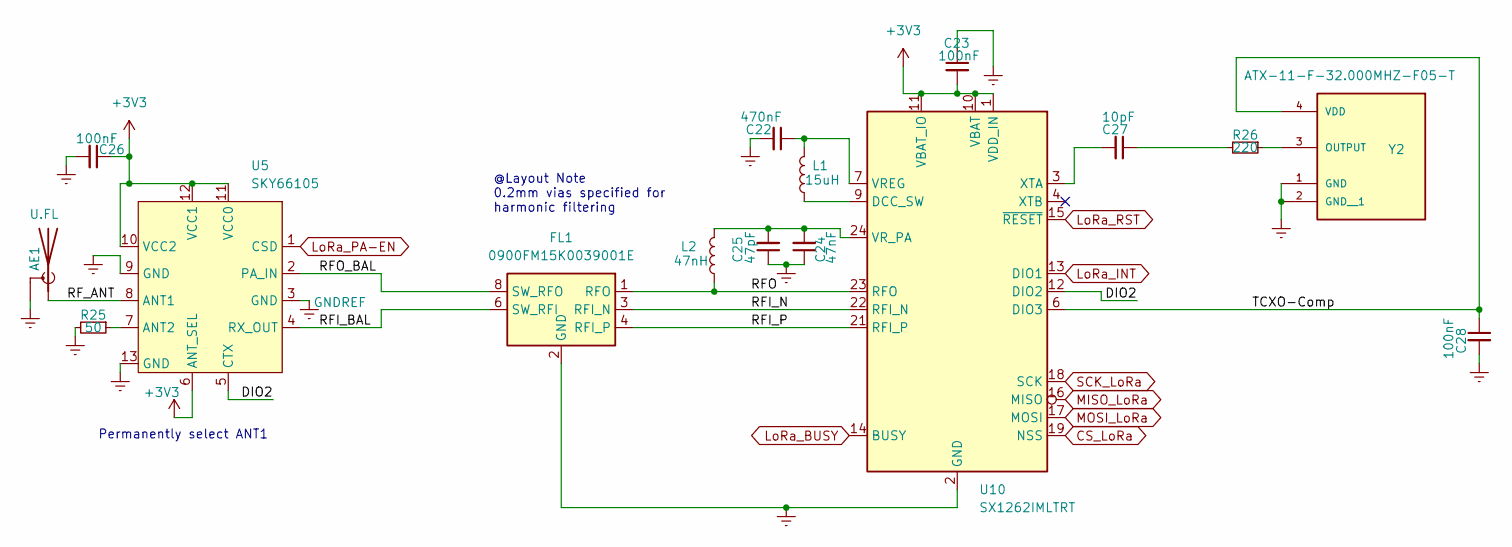
[picture p37: schematic LoRa Radio.kicad_sch, WINTER 915MHz LoRa Radio]

Parts:
AE1: U.FL; U.FL_Molex_MCRF_73412-0110_Vertical; LCSC C434806
C22: 470nF; C_0603_1608Metric; LCSC C1623
C23, C26, C28: 100nF; C_0603_1608Metric; LCSC C1590
C24: 47nF; C_0201_0603Metric; LCSC C85925
C25: 47pF; C_0201_0603Metric; LCSC C85908
C27: 10pF; C_0603_1608Metric; LCSC C32949
FL1: 0900FM15K0039001E; Balun_Johanson_0900FM15K0039; LCSC C1513363
L1: 15uH; L_0805_2012Metric; LCSC C383402
L2: 47nH; L_0402_1005Metric; LCSC C76776
R25: 50; R_0402_1005Metric; LCSC C227387
R26: 220; R_0603_1608Metric; LCSC C25091
U5: SKY66105; SKY66105-11; LCSC C2654446
U10: SX1262IMLTRT; QFN-24-1EP_4x4mm_P0.5mm_EP2.6x2.6mm; LCSC C191341
Y2: ATX-11-F-32.000MHZ-F05-T; OSC_ATX-11-F-32.000MHZ-F05-T; PARTREV 11-11-20; LCSC C5978624

Connections:
+3V3: C23.2, C26.1, U5.6 (ANT_SEL), U5.10 (VCC2), U5.11 (VCC0), U5.12 (VCC1), U10.1 (VDD_IN), U10.10 (VBAT), U10.11 (VBAT_IO); also elsewhere on the board
/LoRa Radio/DIO2: U5.5 (CTX), U10.12 (DIO2)
/LoRa Radio/RFI_BAL: FL1.6 (SW_RFI), U5.4 (RX_OUT)
/LoRa Radio/RFI_N: FL1.3 (RFI_N), U10.22 (RFI_N)
/LoRa Radio/RFI_P: FL1.4 (RFI_P), U10.21 (RFI_P)
/LoRa Radio/RFO: FL1.1 (RFO), L2.1, U10.23 (RFO)
/LoRa Radio/RFO_BAL: FL1.8 (SW_RFO), U5.2 (PA_IN)
/LoRa Radio/RF_ANT: AE1.1 (A), U5.8 (ANT1)
/LoRa Radio/TCXO-Comp: C28.1, U10.6 (DIO3), Y2.4 (VDD)
CS_LoRa: U10.19 (NSS); also elsewhere on the board
GNDREF: AE1.2 (Shield), C22.2, C23.1, C24.1, C25.1, C26.2, C28.2, FL1.2 (GND), FL1.5 (GND), FL1.7 (GND), FL1.9 (GND), FL1.10 (GND), R25.2, U5.3 (GND), U5.9 (GND), U5.13 (GND), U10.2 (GND), U10.5 (GND), U10.8 (GND), U10.20 (GND), U10.25 (GND), Y2.1 (GND), Y2.2 (GND__1); also elsewhere on the board
LoRa_BUSY: U10.14 (BUSY); also elsewhere on the board
LoRa_INT: U10.13 (DIO1); also elsewhere on the board
LoRa_PA-EN: U5.1 (CSD); also elsewhere on the board
LoRa_RST: U10.15 (~RESET); also elsewhere on the board
MISO_LoRa: U10.16 (MISO); also elsewhere on the board
MOSI_LoRa: U10.17 (MOSI); also elsewhere on the board
unnamed: C27.1, R26.2
unnamed: R25.1, U5.7 (ANT2)
unnamed: L1.1, U10.9 (DCC_SW)
unnamed: C22.1, L1.2, U10.7 (VREG)
unnamed: C24.2, C25.2, L2.2, U10.24 (VR_PA)
unnamed: C27.2, U10.3 (XTA)
unnamed: R26.1, Y2.3 (OUTPUT)
SCK_LoRa: U10.18 (SCK); also elsewhere on the board

Notes on the sheet:
Permanently select ANT1
@Layout Note 0.2mm vias specified for harmonic filtering

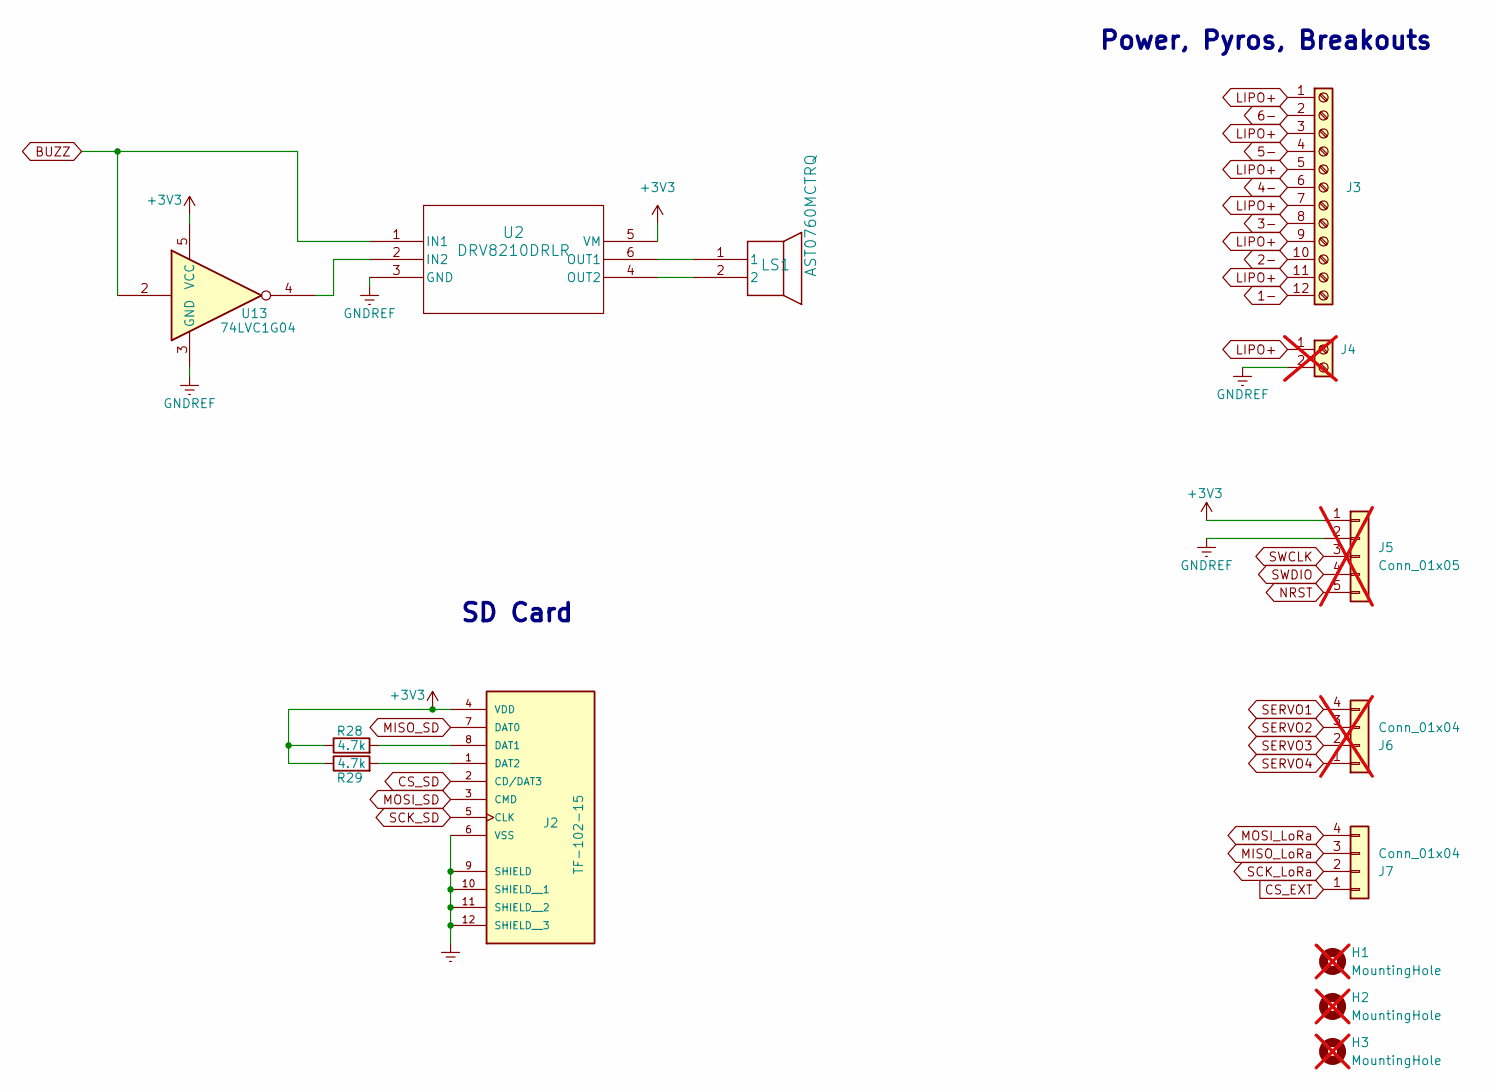
[picture p38: schematic Peripherals.kicad_sch, WINTER Peripheral Items]

Parts:
H1, H2, H3: MountingHole; MountingHole_2.2mm_M2_ISO7380_Pad_TopOnly; LCSC DNP; not fitted
J2: TF-102-15; microSD_GCT_MEM2067-02-180-00; LCSC C266609
J3: Screw_Terminal_01x12; TerminalBlock_Phoenix_MPT-0,5-12-2.54_1x12_P2.54mm_Horizont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; LCSC DNP
J4: Screw_Terminal_01x02; SolderWire-0.75sqmm_1x02_P7mm_D1.25mm_OD3.5mm; LCSC DNP; not fitted
J5: Conn_01x05; PinHeader_1x05_P2.54mm_Vertical; LCSC DNP; not fitted
J6: Conn_01x04; PinHeader_1x04_P2.54mm_Vertical; LCSC DNP; not fitted
J7: Conn_01x04; PinHeader_1x04_P2.54mm_Vertical; LCSC DNP
LS1: AST0760MCTRQ; AST0760_MAL; LCSC C5949284
R28, R29: 4.7k; R_0603_1608Metric; LCSC C23162
U2: DRV8210DRLR; SOT_210DRLR_TEX; LCSC C3681297
U13: 74LVC1G04; Texas_R-PDSO-G5_DCK-5; LCSC C8207

Connections:
1-: J3.12; also elsewhere on the board
2-: J3.10; also elsewhere on the board
3-: J3.8; also elsewhere on the board
4-: J3.6; also elsewhere on the board
5-: J3.4; also elsewhere on the board
6-: J3.2; also elsewhere on the board
+3V3: J2.4 (VDD), J5.1, R28.1, R29.1, U2.5 (VM), U13.5 (VCC); also elsewhere on the board
BUZZ: U2.1 (IN1), U13.2; also elsewhere on the board
CS_EXT: J7.1; also elsewhere on the board
CS_SD: J2.2 (CD/DAT3); also elsewhere on the board
GNDREF: J2.6 (VSS), J2.9 (SHIELD), J2.10 (SHIELD__1), J2.11 (SHIELD__2), J2.12 (SHIELD__3), J4.2, J5.2, U2.3 (GND), U13.3 (GND); also elsewhere on the board
LIPO+: J3.1, J3.3, J3.5, J3.7, J3.9, J3.11, J4.1; also elsewhere on the board
MISO_LoRa: J7.3; also elsewhere on the board
MISO_SD: J2.7 (DAT0); also elsewhere on the board
MOSI_LoRa: J7.4; also elsewhere on the board
MOSI_SD: J2.3 (CMD); also elsewhere on the board
NRST: J5.5; also elsewhere on the board
unnamed: J2.8 (DAT1), R28.2
unnamed: J2.1 (DAT2), R29.2
unnamed: U2.2 (IN2), U13.4
unnamed: LS1.1, U2.6 (OUT1)
unnamed: LS1.2, U2.4 (OUT2)
SCK_LoRa: J7.2; also elsewhere on the board
SCK_SD: J2.5 (CLK); also elsewhere on the board
SERVO1: J6.4; also elsewhere on the board
SERVO2: J6.3; also elsewhere on the board
SERVO3: J6.2; also elsewhere on the board
SERVO4: J6.1; also elsewhere on the board
SWCLK: J5.3; also elsewhere on the board
SWDIO: J5.4; also elsewhere on the board

Notes on the sheet:
SD Card
Power, Pyros, Breakouts

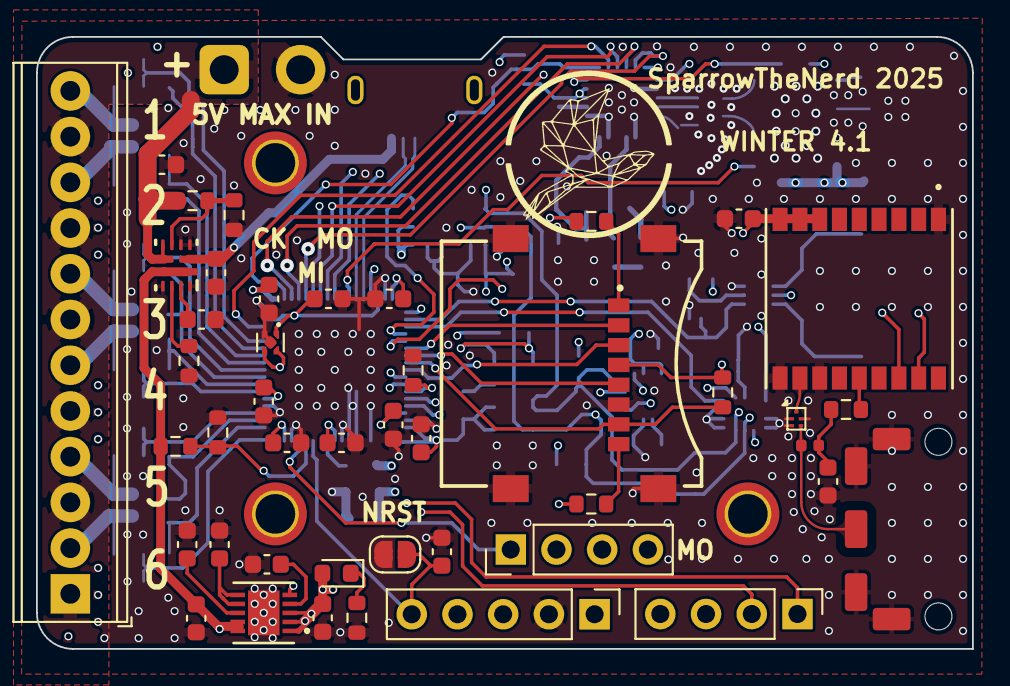
[picture p39: board WINTER.kicad_pcb from above]

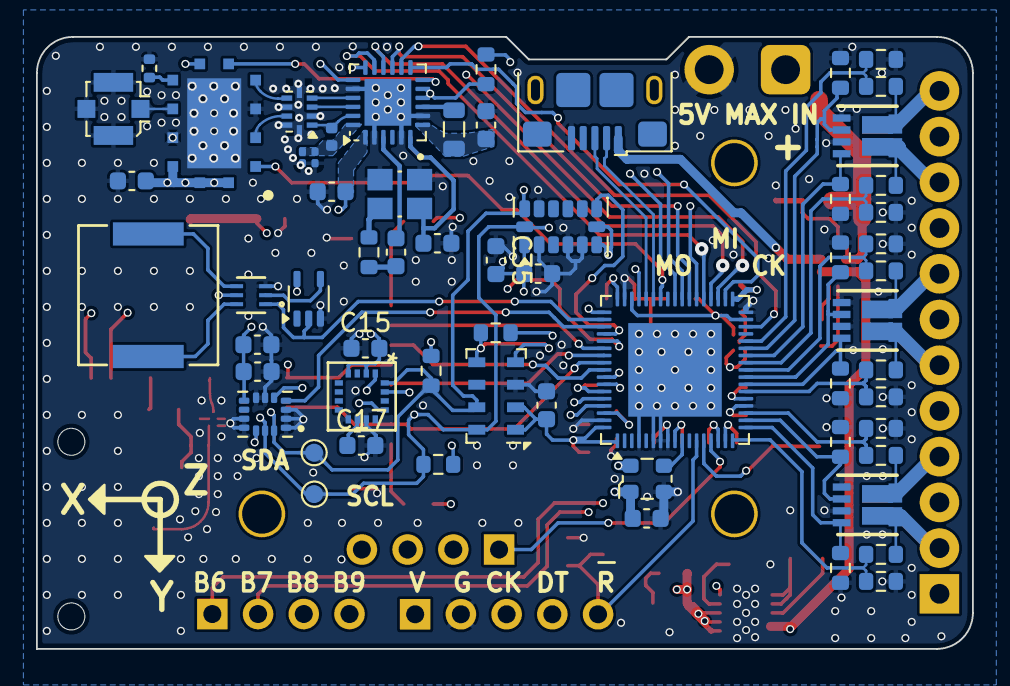
[picture p40: board WINTER.kicad_pcb from below]

Board: 6 copper layers, 52.0 x 34.0 mm, 109 parts (61 on the bottom side), 88 nets.
