SparrowTheNerd/WINTER-KiCAD/Datasheets etc/SX1262/SX1262-IPD-Design/SX126xIPD_868-915MHz_Altium_PCB_Package/IPD_KiCAD/IPD_KiCAD.kicad_pcb

## KiCad design Datasheets etc/SX1262/SX1262-IPD-Design/SX126xIPD_868-915MHz_Altium_PCB_Package/IPD_KiCAD/IPD_KiCAD.kicad_pcb (2025-06-22)

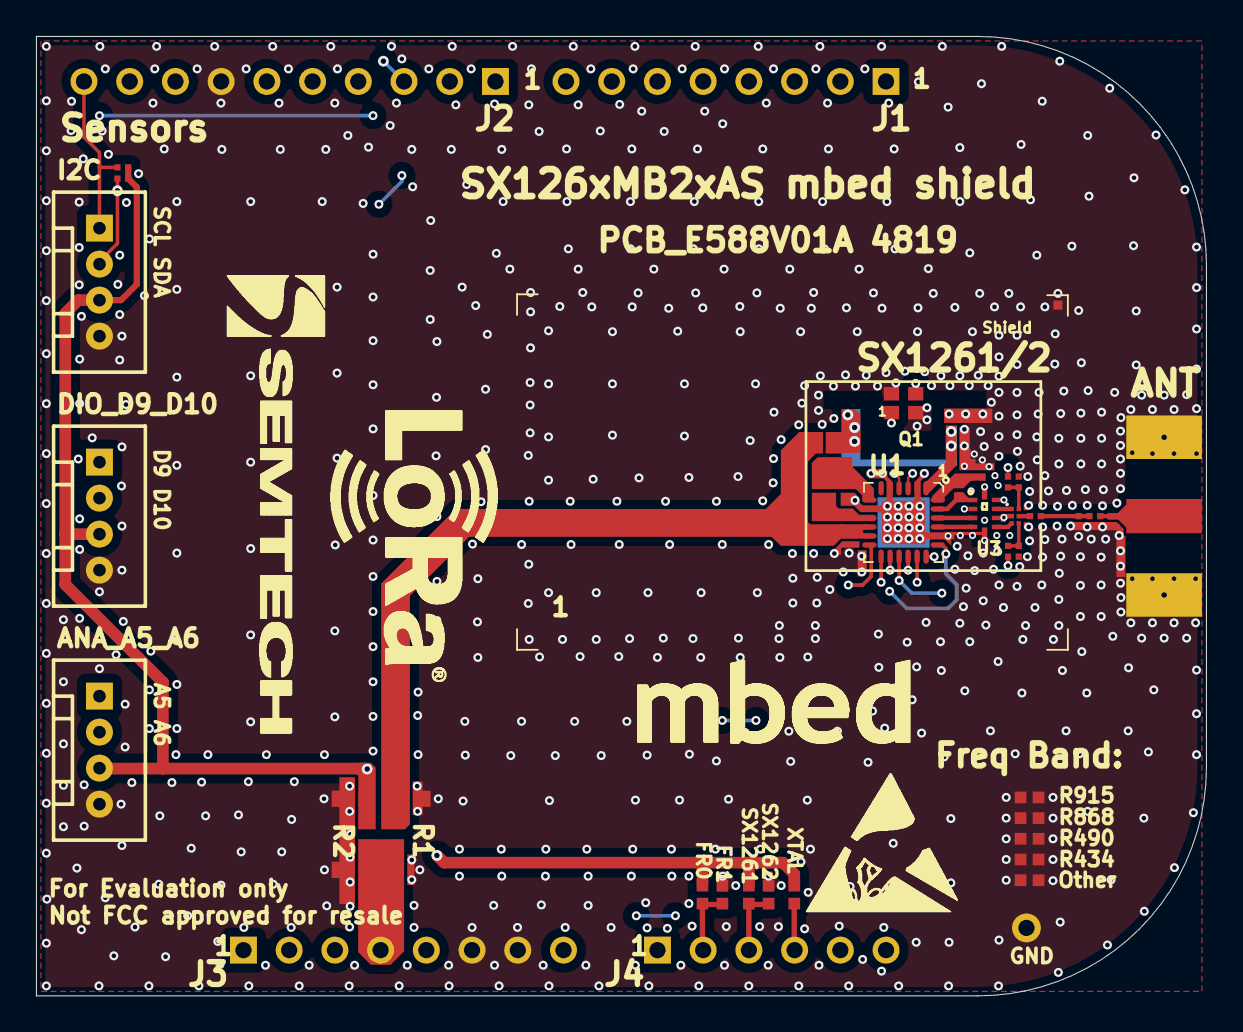
[picture p41: board IPD_KiCAD.kicad_pcb from above]

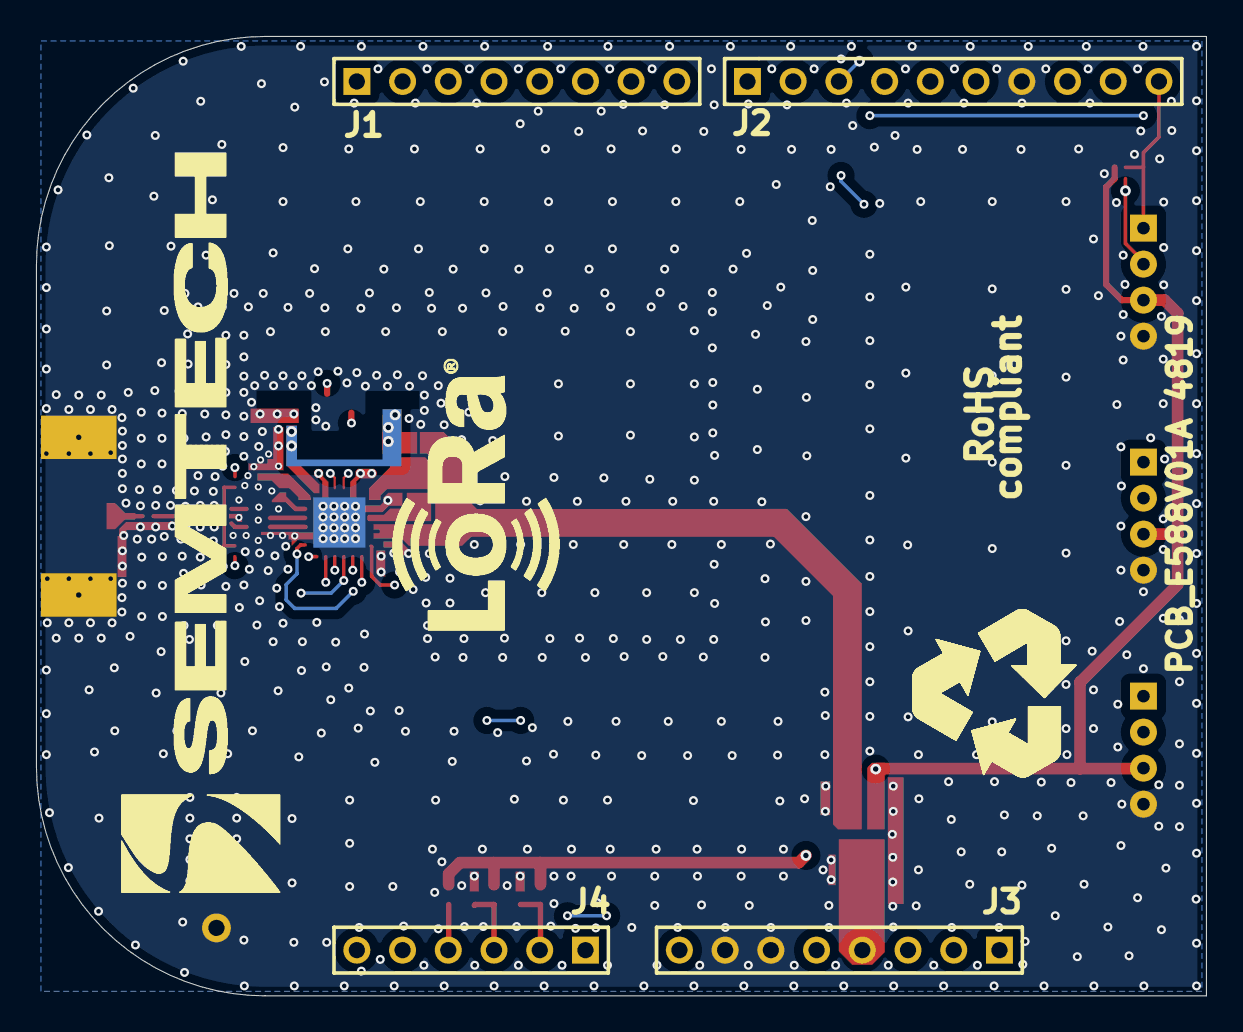
[picture p42: board IPD_KiCAD.kicad_pcb from below]

Board: 4 copper layers, 65.0 x 53.3 mm, 56 parts (7 on the bottom side), 38 nets.

Parts:
ANA_A5_A6: Header 4; 1125S-4P_connector
ANT: SMA; SMA_end_launch_1.0mm_9.52mm
C1, C9, C10: Cap; rlc_201_smd
C2, C8, C14, C15, C18, C23: Cap; RLC_201_SMD
C16, C17: Cap; rlc_402_smd_small
C20, C21, C22: Cap; RLC_603_SMD
DIO_D9_D10: Header 4; 1125S-4P_connector
FR0, FR1: Resistor; RLC_402_SMD
GND: Test Pin; pin_0.9mm
I2C: Header 4; 1125S-4P_connector
J1, J3: Header 8; HDR1X8
J2: Header 10; HDR1X10
J4: Header 6; HDR1X6
L1, L8: Inductor; rlc_402_smd_small
L5: Inductor; rlc_201_smd
L7: Inductor; rlc_805_smd_small
Logo Bot1: Logo symbol; Logo LoRa Size4
Logo ESD1: Logo symbol; Logo ESD
Logo Recycling1: Logo symbol; Logo Recycling1
Logo Semtech_1: Logo symbol; logo_semtech_horiz_size3
Logo_LoRA_Top1: Logo symbol; Logo LoRa Size4
Logo_Semtech1: Logo symbol; logo_semtech_horiz_size4
Logo_mbed1: Logo symbol; logo mbed 2
Other: Resistor; RLC_402_SMD
Q1: Xtal; nd2016da
R1, R2: Resistor; RLC_603_SMD
R3, R4, R5, R6: Resistor; RLC_201_SMD
R18: Resistor; rlc_402_smd_small
R434, R490, R868, R915: Resistor; RLC_402_SMD
SX1261, SX1262: Resistor; RLC_402_SMD
Shield: Logo symbol; BMIS-209-F - Shield
U1: SX1261/2; VQFN24_4X4MM
U2: BGS12SN6 RF Switch; TSNP-6-2
U3: 0900FM15D0039; IPD FILTER
XTAL: Resistor; RLC_402_SMD

Connections:
A5: ANA_A5_A6.1, J4.5
A6: ANA_A5_A6.2, J4.6
ANT_SW: J2.1, R3.2
BUSY: J1.4, U1.14
D9: DIO_D9_D10.1, J2.2
D10: DIO_D9_D10.2, J2.3
DIO1: J1.6, U1.13
DIO2: R4.2, U1.12
GND: ANA_A5_A6.4, ANT.2, C1.1, C2.1, C9.1, C10.1, C14.2, C15.2, C16.1, C17.1, C18.1, C20.1, C21.1, C22.1, C23.1, DIO_D9_D10.4, FR1.1, GND.1, I2C.4, J2.7, J3.6, J3.7, Other.1, Other.2, Q1.2, Q1.4, R434.1, R434.2, R490.1, R490.2, R868.1, R868.2, R915.1, R915.2, SX1262.1, Shield.1, U1.2, U1.5, U1.8, U1.20, U1.25, U2.2, U3.2, U3.5, U3.7, U3.9, U3.10
I2C_SCL: I2C.1, J2.10, R6.1
I2C_SDA: I2C.2, J2.9, R5.1
MISO: J2.5, U1.16
MOSI: J2.4, U1.17
NSS: J1.8, U1.19
NetANT_1: ANT.1, C10.2, L5.2
NetC8_1: C8.1, C9.2, L5.1
NetC8_2: C8.2, U2.5
NetC14_1: C14.1, R4.1, U2.6
NetC15_1: C15.1, R3.1, U2.4
NetC16_2: C16.2, L8.1, R18.1, U1.1
NetC17_2: C17.2, L7.1, L8.2, U1.7
NetFR0_2: FR0.2, FR1.2, J4.2
NetJ4_3: J4.3, SX1261.2, SX1262.2
NetL1_1: L1.1, U1.23, U3.1
NetL7_2: L7.2, U1.9
NetU1_21: U1.21, U3.4
NetU1_22: U1.22, U3.3
NetU2_1: U2.1, U3.8
NetU2_3: U2.3, U3.6
OPT: J4.4, XTAL.2
SCK: J2.6, U1.18
SX_NRESET: J4.1, U1.15
VDD_3V3: ANA_A5_A6.3, C21.2, DIO_D9_D10.3, FR0.1, I2C.3, R2.1, R5.2, R6.2, SX1261.1, XTAL.1
VDD_MBED: C22.2, C23.2, J3.4, R1.2, R2.2
VDD_RADIO: C18.2, C20.2, R1.1, R18.2, U1.10, U1.11
VR_PA: C1.2, C2.2, L1.2, U1.24
XTA: Q1.3, U1.3
XTB: Q1.1, U1.4
