SparrowTheNerd/WINTER-KiCAD/(commit log)

2025-08-28 Updated file naming and keep only latest board version in master
    [0472192001.step, 10118193-0001LF.step, 2023-07-15.xlsx, AST0760_MAL.step, AdafruitGPS v2.step, BoM & Pricing.xlsx, BoM.xlsx, CC1190RGVT.step]
2025-08-28 Fix footprints and update rev number
    [GPS.kicad_sch, IPD_KiCAD.kicad_pcb, IPD_KiCAD.kicad_sch, LoRa Radio.kicad_sch, Peripherals.kicad_sch, Power.kicad_sch, SX126xMB2xAS_e588v01a.PcbDoc, SX126xMB2xAS_e588v01a.PcbLib]
2025-08-28 Added previously missing V_CORE 1.35V regulator
    [Power.kicad_sch, WINTER.kicad_pcb, microcontroller.kicad_sch]
2025-08-28 Some layout tweaks
    [Power.kicad_sch, WINTER.kicad_pcb, microcontroller.kicad_sch]
2025-09-04 Started new layout and updated power circuitry
    [2998TR.step, GPS.kicad_sch, Power.kicad_sch, WINTER.kicad_pcb]
2025-11-05 updated power delivery and component choices. v4 now ready
    [AP.10H.01_Web.STEP, CP-10-9_ADI.step, GPS.kicad_sch, LoRa Radio.kicad_sch, Peripherals.kicad_sch, Power.kicad_sch, Sensors.kicad_sch, TPS2121RUXR.STEP]
2025-11-26 Fixed power distribution and made small improvements. Updated revision number
    [GPS.kicad_sch, LoRa Radio.kicad_sch, Peripherals.kicad_sch, Power.kicad_sch, Sensors.kicad_sch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]
